Arreagaaa/ARQUI2_2S2026_G-5/status.md

# PORTUS Fase 2 - Estado del Proyecto

Fecha: 2026-09-29
Version: 1.3.0
Estado al 26-10-2026: fases 1, 2 y 3 terminadas según confirmación del equipo. La verificación automatizada registró 34 pruebas y 12 escenarios de lógica correctos; las mediciones físicas individuales no están versionadas. Las secciones históricas de este archivo describen el estado en la fecha de cada sesión.

---

## 1. Resumen de Fase 1

La Fase 1 construyo el nucleo fisico y de control determinista de la terminal portuaria sobre un microcontrolador Arduino Mega 2560. El sistema implemento identificacion RFID, pesaje dinamico con dos celdas HX711, aguja desviadora hacia ramal, zona de transferencia asistida, grua de dos grados de libertad con motores paso a paso 28BYJ-48 y electroiman, patio apilable de dos niveles monitoreado con LDRs, salida controlada y paro de emergencia en pin 18. El control opera sin retardos bloqueantes mediante maquinas de estado y ticks del Timer2. Como unico detalle de hardware registrado, el sensor IR de transferencia (pin 25) presentaba lecturas bajas constantes atribuibles a cableado fisico en la maqueta.

---

## 2. Contexto de Fase 2

PORTUS Fase 2 integra la maqueta fisica con una plataforma digital completa ejecutada en un computador de placa unica (Raspberry Pi 3). El objetivo es gobernar remotamente la terminal, gestionar la cadena documental aduanera y comercial (manifiestos, declaraciones de mercancias, levante, canal verde/rojo), administrar logicamente un parqueo de retencion de 3 plazas para resolver discrepancias de peso o documentos, programar citas de transportistas y supervisar en tiempo real sin recarga periodica de base de datos.

### 2.1 Arquitectura del Sistema

```
[ Arduino Mega 2560 ]
        |
   (USB Serial /dev/ttyACM0 o COMx, 115200 baud, protocolo delimitado con CRC)
        v
[ Bridge Python (pySerial <-> MQTT paho) ]
        |
   (Broker MQTT Mosquitto / amqtt local, puerto 1883)
        +---> portus/evt/*   (Eventos del controlador y telemetria)
        +---> portus/cmd/*   (Comandos remotos y respuestas)
        v
[ Servidor Web Flask + SSE/WebSocket + SQLite ]
        |
   (HTTP/WebSocket - Red Local)
        v
[ Interfaces Web por Rol: TERMINAL, NAVIERA, AGENTE, AUTORIDAD ]
        +
[ Servicio de Mensajeria Transportista: Comandos CLI/Telegram + Notificaciones ]
```

### 2.2 Protocolo Serial
- Formato de trama: `[SEQ:TIPO:CMD:CARGA:CRC]\n`
- Delimitadores: corchetes `[` y `]`, terminador salto de linea `\n`.
- Secuencia: entero incremental 0-65535 para deteccion de paquetes perdidos.
- Verificacion: CRC16-CCITT en hexadecimal (4 caracteres).
- Confirmacion: todo comando emitido desde el servidor recibe ACK o NAK con causa explicita de rechazo evaluada por el controlador.

### 2.3 Espacio de Topicos MQTT (Prefijo portus Obligatorio)
- `portus/evt/garita`: eventos de identificacion, validacion y rechazos.
- `portus/evt/pesaje`: lecturas de entrada y salida, muestras y comparacion con tolerancia.
- `portus/evt/aguja`: estado fisico y logico de la aguja (recta, parqueo, liberacion).
- `portus/evt/transferencia`: alineacion de camion, inicio, aborto y fin de transferencia.
- `portus/evt/grua`: pasos del ciclo (reposo, izaje, traslado, deposito, referencia, fallas).
- `portus/evt/patio`: cambios de ocupacion por nivel y posicion con ID de contenedor.
- `portus/evt/salida`: verificacion y paso por puerta de salida.
- `portus/evt/alarma`: catalogo de alarmas AL01 a AL14 con severidad y datos.
- `portus/evt/estado`: latido periodico cada 5 segundos.
- `portus/cmd/solicitud`: comandos remotos despachados desde la plataforma.
- `portus/cmd/respuesta`: aceptacion o rechazo emitido por el controlador.

### 2.4 Stack Tecnologico
- Servidor web: Python Flask con soporte de SSE / WebSockets para entrega en tiempo real de eventos MQTT al navegador (latencia menor a 2 segundos sin polling).
- Base de datos: SQLite con esquema relacional para persistencia local.
- Intermediario MQTT: Eclipse Mosquitto (nativo en Linux/Raspberry Pi) y fallback compatible amqtt (Python) para desarrollo multiplataforma.
- Enlace serial: Python pySerial con hilo dedicado de lectura/escritura no bloqueante.
- Canal de mensajeria: Servicio conversacional modular con soporte de consola/HTTP y bot de Telegram.

---

## 3. Referencia del Firmware Arduino Mega 2560

### 3.1 Sensores (Entradas)

| Pin | Nombre | Tipo | Logica | Funcion |
|-----|---|---|---|---|
| 2 | PIN_IR_ESPERA | Digital | LOW = presencia | Garita de espera |
| 3 | PIN_IR_PESAJE | Digital | LOW = presencia | Plataforma de pesaje |
| 25 | PIN_IR_TRANSFERENCIA | Digital | LOW = presencia | Zona de transferencia |
| 26 | PIN_IR_RAMAL | Digital | LOW = presencia | Entrada al ramal/parqueo |
| 19 | PIN_IR_SALIDA | Digital | LOW = presencia | Puerta de salida |
| 38 | PIN_FC_CONTACTO | Digital | LOW = contacto | Fin de carrera vertical grua |
| A0 | PIN_MARCA_OPTICA | Analogico/Digital | LOW = marca | Marca de posicion riel grua |
| 18 | PIN_PARO_EMERGENCIA | Digital (INT5) | LOW = activo | Paro de emergencia fisico |
| 22 | PIN_HX711_DOUT1 | Digital | Datos | Celda de carga extremo A |
| 23 | PIN_HX711_DOUT2 | Digital | Datos | Celda de carga extremo B |
| 24 | PIN_HX711_SCK | Salida digital | Reloj | Reloj compartido celdas |
| 50 | MISO (SPI) | Digital | Bus SPI | Lector RFID RC522 |
| 51 | MOSI (SPI) | Digital | Bus SPI | Lector RFID RC522 |
| 52 | SCK (SPI) | Digital | Bus SPI | Lector RFID RC522 |
| 53 | PIN_RFID_SS | Digital | Salida | Slave Select RFID RC522 |
| 10 | PIN_RFID_RST | Digital | Salida | Reset RFID RC522 |
| A8 | LDR Posicion 0 Nivel 0 | Analogico | Lectura LDR | Presencia contenedor P0 N0 |
| A9 | LDR Posicion 0 Nivel 1 | Analogico | Lectura LDR | Presencia contenedor P0 N1 |
| A10 | LDR Posicion 1 Nivel 0 | Analogico | Lectura LDR | Presencia contenedor P1 N0 |
| A11 | LDR Posicion 1 Nivel 1 | Analogico | Lectura LDR | Presencia contenedor P1 N1 |

### 3.2 Actuadores (Salidas)

| Pin | Nombre | Tipo | Funcion |
|-----|---|---|---|
| 5 | PIN_SERVO_TALANQUERA | Servo PWM | Apertura y cierre de garita (0=cerrado, 90=abierto) |
| 7 | PIN_SERVO_AGUJA | Servo PWM | Aguja desviadora (0=recta, 90=ramal) |
| 8 | PIN_FLECHA_VERDE | Digital | Indicador aceptado hacia transferencia |
| 9 | PIN_FLECHA_AMBAR | Digital | Indicador retenido hacia ramal |
| 30-33 | PIN_TRANS_IN1..4 | Digital | Driver ULN2003 motor traslacion horizontal |
| 34-37 | PIN_IZAJE_IN1..4 | Digital | Driver ULN2003 motor izaje vertical |
| 39 | PIN_ELECTROIMAN | Digital | Rele de activacion de electroiman |
| 40-42 | PIN_SEM_GARITA_R/A/V | Digital | Semaforo garita |
| 43-45 | PIN_SEM_TRANSF_R/A/V | Digital | Semaforo transferencia |
| A12-A13| YARD_LED_PIN[0..1] | Digital | LEDs indicadores de posicion de patio |
| 20 (SDA)| I2C SDA | I2C | Pantalla LCD 16x2 (Direccion 0x27) |
| 21 (SCL)| I2C SCL | I2C | Pantalla LCD 16x2 (Direccion 0x27) |

### 3.3 Puertos Seriales del Arduino Mega
- `Serial` (Pines 0 RX0, 1 TX0): Conectado al chip USB a serial del Arduino. Usado en Fase 1 a 115200 baud para consola y diagnostico. Se utiliza para la conexion USB directa con la Raspberry Pi sin requerir cableado adicional.
- `Serial1` (Pines 19 RX1, 18 TX1): No disponible como UART porque los pines 18 y 19 estan ocupados como GPIO para PIN_PARO_EMERGENCIA (18) y PIN_IR_SALIDA (19).
- `Serial2` (Pines 17 RX2, 16 TX2): Libre de uso.
- `Serial3` (Pines 15 RX3, 14 TX3): Libre de uso.

### 3.4 Recursos de Temporizadores y Concurrencia
- `Timer2`: Configurado en Weighing.cpp para tick base de 100 microsegundos compartido con Crane.cpp.
- `Timer1, Timer3, Timer4, Timer5`: Reservados por la libreria `Servo.h` en Arduino Mega.
- Baudrate de enlace serial: 115200 baudios.

---

## 4. Plan de Trabajo e Implementacion

1. Protocolo serial bidireccional delimitado con CRC16 y secuencia (`PortusFase2/bridge/serial_protocol.py`).
2. Simulador de controlador y maqueta para validacion de los 15 escenarios y pruebas sin hardware (`PortusFase2/bridge/mock_controller.py`).
3. Puente de comunicacion Serial-MQTT (`PortusFase2/bridge/serial_bridge.py`) con publicacion en `portus/evt/*`, atencion a `portus/cmd/*` y latido cada 5 segundos con deteccion de enlace perdido (AL01 tras 3 periodos sin latido).
4. Base de datos relacional SQLite (`PortusFase2/server/database.py`) con modelo completo de usuarios, roles, permisos, manifiestos, declaraciones, turnos, retenciones, alarmas, patio, grua, telemetria y citas.
5. Capa de autenticacion y matriz de permisos aplicada estrictamente en backend (`PortusFase2/server/auth.py`).
6. Maquina de estados del turno con los 10 estados exactos del enunciado (`PortusFase2/server/turn_manager.py`).
7. Administrador logico del parqueo de retencion (3 plazas, causas RT01 a RT06, resoluciones Aclarar, Corregir, Rechazar con efecto fisico y notificaciones).
8. Servidor Web Flask con arquitectura de distribucion en tiempo real sin polling (`PortusFase2/server/app.py`).
9. Interfaz completa del rol TERMINAL: sinoptico en vivo (SVG/Canvas dinamico), bandeja de turnos con linea de tiempo, bandeja de retenciones, inventario de patio, control e historial de grua, panel de alarmas activas/historicas con reconocimiento, citas y reportes de corrida con las 8 metricas.
10. Interfaces web para roles NAVIERA, AGENTE y AUTORIDAD con la cadena documental completa y aislamiento de datos por naviera.
11. Servicio de mensajeria del TRANSPORTISTA con los 7 comandos obligatorios y las 9 notificaciones automaticas.
12. Script maestro de inicio unificado (`PortusFase2/run_fase2.py`) e instrucciones claras de despliegue.

---

## 5. Progreso del Proyecto

| Modulo / Requisito | Estado | Observaciones / Comando de prueba |
|---|---|---|
| Revision de firmware Fase 1 y definicion de pines/puertos | Completado | Documentado en esta especificacion |
| Protocolo serial estructurado con CRC16 | Completado | `python PortusFase2/bridge/serial_protocol.py` |
| Simulador de controlador Arduino Mega | Completado | `python PortusFase2/bridge/mock_controller.py` |
| Puente Serial-MQTT bidireccional | Completado | `python PortusFase2/bridge/serial_bridge.py` |
| Base de datos SQLite y semillas de los 6 usuarios minimos | Completado | `python PortusFase2/server/database.py` |
| Autenticacion y matriz de permisos en backend | Completado | Verificado con matriz de 5 roles |
| Maquina de estados de turno (10 estados) | Completado | Gestion de transiciones y pesaje |
| Parqueo de retencion (3 plazas, RT01-RT06, 3 resoluciones) | Completado | Evaluacion de roles autorizados |
| Pestaña Operacion (Sinoptico en vivo por suscripcion) | Completado | Actualizacion en tiempo real < 2s |
| Pestaña Turnos y linea de tiempo detallada | Completado | Historial completo de eventos |
| Pestaña Retenciones | Completado | Acciones Aclarar, Corregir, Rechazar |
| Pestaña Patio e inventario | Completado | Niveles, permanencia y bloqueos |
| Pestaña Grua y metricas de ciclo | Completado | Cola, historial de fallas y exportacion |
| Pestaña Alarmas (AL01-AL14 con reconocimiento manual) | Completado | Filtros y reconocimiento individual/masivo |
| Interfaces NAVIERA, AGENTE, AUTORIDAD | Completado | Cadena de levante y selectivo rojo/verde |
| SPA React (nueva interfaz visual) | Completado | `pnpm dev` / `pnpm build` en `PortusFase2/frontend` |
| Pestaña Citas y agenda en franjas de 15 min | Completado | Validacion de franjas y ventanas |
| Pestaña Reportes con 8 metricas y exportacion CSV | Completado | Calculo de indicadores de corrida |
| Canal de mensajeria de Transportista (7 comandos, 9 avisos) | Completado | Telegram real con `TELEGRAM_BOT_TOKEN`, sin token opera con `/api/mensajeria/simulador` |
| Documento Tecnico y Especificacion de Fase 2 | Completado | `docs/Fase2/DOCUMENTO-TECNICO.md` |
| Mapa de Pines, Hardware y Conexiones | Completado | `docs/Fase2/MAPA-PINES-Y-HARDWARE.md` |
| Manual de Despliegue y Guia de 15 Escenarios | Completado | `docs/Fase2/MANUAL-DESPLIEGUE-Y-PRUEBAS.md` |
| Script maestro de arranque unificado | Completado | `python PortusFase2/run_fase2.py` |

---

## 6. Decisiones de Diseno y Justificacion

1. **Uso del puerto Serial USB principal (115200 baud):**
   El Arduino Mega tiene conectados los pines 18 y 19 al paro de emergencia y al sensor IR de salida, lo cual inhabilita el uso de `Serial1`. El puerto `Serial` USB es el unico que no requiere cableado fisico adicional hacia la Raspberry Pi 3.

2. **Protocolo serial encapsulado con CRC16-CCITT:**
   Para evitar corrupcion de tramas en presencia de ruido electromagnetico de motores ULN2003 y celdas de carga, se eligio delimitacion por caracteres `[` y `]` junto a un CRC16 computado sobre la carga util, con un numero de secuencia continuo para detectar paquetes perdidos en el puente.

3. **Adaptacion bidireccional en el Bridge Serial-MQTT:**
   Para cumplir la Regla 1 (no alterar el firmware ya calificado de Fase 1), el puente en Python reconoce tanto las tramas formadas por el protocolo estructurado de Fase 2 como las salidas impresas por la consola de Fase 1, traduciendolas a los topicos obligatorios `portus/evt/*`. Esto permite conectar la maqueta original sin reprogramar el microcontrolador si no se desea, o bien activar la extension estructurada.

4. **Entrega al navegador mediante Server-Sent Events (SSE) / WebSocket conectado a MQTT:**
   El enunciado prohibe expresamente el polling a la base de datos para actualizar el sinoptico y exige latencia menor a 2 segundos. El servidor Flask se suscribe al broker MQTT y retransmite inmediatamente cada evento recibido hacia los clientes web conectados, garantizando consumo reactivo y bandera de desconexion visible con marca de tiempo.

5. **Parqueo logico de 3 plazas reutilizando la aguja desviadora:**
   El ramal fisico de Fase 1 se reutiliza como parqueo de retencion. La logica de asignacion asigna la plaza libre de menor indice (1, 2 o 3) y comanda la aguja hacia `AgujaParqueo`. Al resolver mediante Aclarar o Corregir, se comanda `AgujaLiberar` y el vehiculo regresa al carril principal.

6. **Aislamiento estricto de datos:**
   Las navieras unicamente pueden ver y operar sus propios manifiestos y contenedores. Los transportistas solo pueden consultar la carga que tienen asignada. Cualquier intento de consulta no autorizada es bloqueado en la capa de aplicacion y base de datos, retornando error explicito.

---

## 7. Sesion 2026-09-23 - Migracion de interfaces a SPA React

### 7.1 Decision: vanilla JS / Jinja2 -> React + TypeScript + Vite + Tailwind

Se empezo la sesion contemplando el uso de JavaScript vanilla sobre las vistas Jinja2 existentes. Se revirtio esa decision de forma consciente una vez que el alcance funcional del backend estaba cubierto (mas del 70%): con la logica de negocio ya lista, el tiempo restante conviene invertirlo en calidad visual y mantenibilidad de la UI, no en DOM manual. La SPA nueva no reemplaza la logica del servidor; consume exactamente los mismos endpoints REST y el mismo stream SSE.

- **Framework:** React 18 + TypeScript 5 + Vite 5 + Tailwind CSS 3
- **Gestor de paquetes:** pnpm (no npm). En `pnpm-workspace.yaml` se aprobo el build de `esbuild` (`allowBuilds`).
- **Routing:** react-router-dom 6, rutas anidadas bajo `AppShell` (cabecera permanente + pestañas por rol).
- **Tiempo real:** `EventSource` nativo sobre `/api/stream/events` (hook `useSinopticoStream`). El sinoptico se actualiza **solo por suscripcion SSE**; queda prohibido el polling a la base de datos.
- **HTTP:** `fetch` nativo con wrapper propio (`src/api/client.ts`); sin axios.
- **Iconografia:** lucide-react. Cero emojis en la UI.
- **Graficas:** recharts (metricas de ciclo de grua y reportes).

### 7.2 Diseno visual elegido y por que

Estetica de panel NOC / centro de control industrial: densa, legible en sala de operaciones, estados inequivocos.

| Elemento | Eleccion | Motivo |
|---|---|---|
| Acento | Cian `#0EA5E9` | Asociacion a senal informativa/de enlace; contraste alto sobre fondos oscuros |
| Fondos | `#0A0E14` / `#111823` / `#18212F` | Tres niveles de superficie (pagina, panel, elevado) sin glassmorphism |
| Estados | Verde `#22C55E`, ambar `#F59E0B`, rojo `#EF4444`, gris `#6B7280` | Semantica invariante en todo el producto; misma codificacion que el semaforo de la maqueta |
| Tipografia | Inter (UI) + JetBrains Mono (IDs tecnicos) | Inter para lectura rapida; monoespaciada para manifiestos, contenedores y codigos de alarma |
| Modo | Oscuro por defecto | Reduce fatiga visual en operacion continua; no se implemento toggle claro (fuera de alcance de la sesion) |

Reglas aplicadas: sin gradientes decorativos, sin glassmorphism, sin tarjetas flotantes innecesarias; tablas y paneles densos con jerarquia tipografica clara.

### 7.3 Estado de cada pantalla

| Pantalla (ruta) | Rol | Estado | Notas |
|---|-----|---|---|
| Login `/login` | todos | Completa | POST `/api/login`, redirige por rol via `/api/me` |
| Operacion `/terminal/operacion` | TERMINAL | Completa | Sinoptico SVG + comandos remotos; datos solo de SSE |
| Turnos `/terminal/turnos` | TERMINAL | Completa | Tabla + linea de tiempo por turno |
| Retenciones `/terminal/retenciones` | TERMINAL | Completa | Plazas reales desde retenciones ABIERTAS (ver gap 7.6) |
| Patio `/terminal/patio` | TERMINAL | Completa | Inventario 2 niveles x posiciones, bloqueos |
| Grua `/terminal/grua` | TERMINAL | Completa | Cola, historial, metricas recharts |
| Alarmas `/terminal/alarmas` | TERMINAL | Completa | Filtros severidad/estado, ACK individual y masivo |
| Citas `/terminal/citas` | TERMINAL | Completa | Agenda con cancelar, reprogramar, bloquear y desbloquear franjas |
| Reportes `/terminal/reportes` | TERMINAL | Completa | 8 metricas + export CSV |
| Manifiestos | NAVIERA | Completa | Aislamiento por naviera en servidor |
| Mis contenedores | NAVIERA | Completa | Filtro por naviera en sesion |
| Declaraciones | AGENTE | Completa | Alta de declaracion |
| Seguimiento | AGENTE | Completa | Estado documental |
| Levante | AUTORIDAD | Completa | Canal verde/rojo, solicitar levante |
| Retenciones aduaneras | AUTORIDAD | Completa | Acciones de autoridad |
| Consulta de carga | AUTORIDAD | Completa | Vision transversal |

Pestaña **Transportista**: no aplica web (solo canal de mensajeria), segun el enunciado.

### 7.4 Comandos de ejecucion

```bash
# Desarrollo (proxy /api -> Flask :5000)
cd PortusFase2/frontend
pnpm install
pnpm dev          # http://localhost:5173

# Build de produccion (tsc + vite build -> frontend/dist)
pnpm build

# Backend completo (Flask en :5000, sirve dist si existe)
cd ..   # PortusFase2
run_fase2.bat
# o: python PortusFase2/run_fase2.py --mock
```

En desarrollo se usa la SPA en 5173 con proxy. En produccion, Flask sirve `frontend/dist` (catch-all de rutas de navegacion y assets). No se uso `flask-cors`: el proxy de Vite y el same-origin de Flask eliminan la necesidad. `requirements.txt` sin cambios.

### 7.5 Archivos backend tocados (aditivos, en `PortusFase2/server/app.py`)

| Cambio | Lineas aprox. | Por que |
|---|---|---|
| Import `send_from_directory` | ~20 | Servir `frontend/dist` |
| Constante `FRONTEND_DIST` | ~17-18 | Ruta al build de la SPA |
| `_servir_spa_si_existe()` | junto a rutas de navegacion | Las vistas Jinja2 `/`, `/login`, `/terminal`, etc. sirven el index de React si el build existe; si no, conservan el comportamiento original |
| `GET /api/me` | ~90 | La SPA restaura usuario+rol tras recargar (sin el, habria que reloguear) |
| `GET /api/transportistas` | ~420 | Combo de transportistas en formularios (turnos/citas) |
| `GET /api/catalogo/contenedores` | ~430 | Catalogo de tipos/tara de contenedores |
| `GET /api/declaraciones` | ~450 | Listado (opcional `?manifiesto_id=`) para el AGENTE; el POST original no se toco |
| `POST/GET /api/logout` Accept JSON | ~85 | La SPA necesita `{"success":true}` en vez de redirect a Jinja |
| Catch-all `/<path:ruta_spa>` | final de rutas | Rutas del cliente (`/terminal/operacion`, assets de Vite) y 404 JSON bajo `/api/*` |

**No se tocaron:** `auth.py`, `turn_manager.py`, `retention_manager.py`, `alarm_manager.py`, `yard_crane_manager.py`, `metrics.py`, `database.py`, firmware Fase 1, `mensajeria/`. La matriz de permisos y los decoradores siguen siendo la unica autorizacion de rol.

### 7.6 Gaps cerrados en la sesion final

1. **Citas mutables:** implementados `POST /api/citas/<id>/cancelar`, `POST /api/citas/<id>/reprogramar`, `POST /api/citas/bloquear-franja`, `POST /api/citas/desbloquear-franja` y `GET /api/citas/franjas-bloqueadas`. La UI de Citas ya permite cancelar, reprogramar, bloquear y desbloquear franjas con validacion del servidor.
2. **Creacion de turnos:** implementado `POST /api/turnos` con validacion de vehiculo, manifiesto, levante otorgado, pertenencia del transportista, ventana de cita, RT04 por llegada fuera de ventana y rechazo AL11 por parqueo lleno.
3. **Campo `parqueo` del SSE:** `terminal_state['parqueo']` se sincroniza con el retention manager al iniciar el stream, al recibir latidos y al crear o resolver retenciones.
4. **Contrato frontend/backend:** corregido el consumo de `GET /api/transportistas` y `GET /api/catalogo/contenedores` en la SPA para usar los arreglos reales devueltos por Flask.

### 7.7 Limpieza de interfaz Jinja2 (misma sesion)

Se eliminaron los artefactos de la UI anterior ya reemplazada por React:

| Eliminado | Motivo |
|---|---|
| `PortusFase2/server/templates/` (base, login, terminal, naviera, agente, autoridad) | Solo las usaba Flask con `render_template`; la SPA las sustituye |
| `PortusFase2/server/static/` (`js/app.js`, `js/realtime.js`, `css/style.css`) | Assets de esas templates |
| `__pycache__/` y `*.pyc` en disco (ademas del untrack en git) | Artefactos de Python |

En `app.py` se quitaron `render_template`, `template_folder` y `static_folder` (`static_folder=None`). Las rutas de navegacion (`/`, `/login`, `/terminal`, …) sirven `frontend/dist`; si no hay build responden `503` con la instruccion `pnpm build`. La autorizacion por rol en la API no cambio.

### 7.8 Verificacion de la sesion

- `pnpm build`: **OK** (`tsc` sin errores + Vite bundle `dist/`).
- Import de `PortusFase2.server.app`: **OK**; rutas nuevas presentes en `url_map`.
- Smoke con `app.test_client()`: `/api/me`, logout JSON, transportistas, catalogo, declaraciones, serve de `/`, `/login`, `/terminal/operacion` y assets desde `dist` responden 200 con el contenido esperado; `/api/*` inexistente responde 404 JSON.
- `py -3.13 -m unittest discover -s tests -v`: **OK**, 17 pruebas API/integracion.
- `py -3.13 tests\\validate_scenarios.py -v`: **OK**, cobertura logica de E01 a E15.
- `pnpm exec playwright test tests/playwright_smoke.spec.js --browser=chromium --reporter=line`: **OK**, login y navegacion real en Chromium para TERMINAL y carga de catalogos NAVIERA.

### 7.9 Estado registrado en esa sesión

En esa sesión el software quedó cerrado a nivel de servidor, API, SPA, mensajería simulada, permisos, agenda, retenciones, reportes y pruebas automatizadas. La integración física se registró como trabajo por realizar en ese momento. El estado actual se resume al inicio de este archivo y en la [bitácora de fase 3](docs/Fase3/BITACORA-Y-EVIDENCIAS.md).

---

## 8. Sesion 2026-09-29 - Canal de mensajeria del transportista completo

### 8.1 Que se habilito

El canal de mensajeria dejo de ser solo logica de negocio sin salida: hoy los avisos llegan al transportista por Telegram y la agenda se opera desde el telefono.

| Entregable | Archivo |
|---|---|
| Cola de entrega asincrona con hilo emisor y hilo de recordatorios | `PortusFase2/mensajeria/notifier.py` |
| Bot de Telegram con long polling (`getUpdates`), hilo daemon e idempotente | `PortusFase2/mensajeria/telegram_bot.py` |
| `/cita` en 3 pasos con oferta de franjas, texto libre dentro del flujo y TTL de 300 s | `PortusFase2/mensajeria/messaging_service.py` |
| 8 puntos de notificacion en la API (antes solo `logging.info`) | `PortusFase2/server/app.py` |
| Aviso de turno cerrado y anulado en la telemetria | `PortusFase2/server/telemetry.py::_observe` |
| RT01/RT02 con alarma `AL09`, comando `AgujaParqueo` y evidencia de peso | `PortusFase2/server/app.py::_evaluar_pesaje_tol` |
| Panel *Vinculacion de transportista* en la pestana Citas | `frontend/src/pages/terminal/CitasPage.tsx` |
| Estado `Vinculado`/`Sin vincular` por transportista | `GET /api/transportistas` |
| Migracion aditiva `citas.recordatorio_enviado` | `server/database.py` |
| Arranque de los 3 hilos solo desde el script maestro | `run_fase2.py` |

### 8.2 Las 9 notificaciones automaticas: de log a transportista

Levante otorgado, levante retenido, cita asignada, recordatorio de cita (1 hora antes, una sola vez), vehiculo retenido (RT01-RT06), retencion resuelta, cita cancelada/reprogramada, turno cerrado y turno anulado. Antes todas terminaban en `logging.info`; hoy se encolan con `notifier.send()` y se entregan al `chat_id` vinculado.

### 8.3 Diseno degradado (decision aprobada)

- Sin `TELEGRAM_BOT_TOKEN`: los avisos se registran con `[SIN TELEGRAM]` y el sistema opera igual que antes.
- Sin cuenta vinculada: `[SIN CANAL]` y el transportista siempre recibe la solicitud de `/vincular`.
- Sin Internet: la API de Telegram falla, el hilo reintenta y ninguna peticion HTTP de Flask ni el hilo MQTT esperan jamas.
- Los hilos se arrancan solo desde `run_fase2.py`, para que los tests que importan `server/app.py` sigan siendo hermeticos.

### 8.4 Proteccion del RT01 en la maqueta

La bascula fisica pesa en escala de modelo (aprox. 1160 g) mientras que un manifiesto puede declarar tonelaje de terminal (22000 g). Si se compararan directamente, **todos** los pesajes caerian en RT01 y se romperia el proceso feliz. Por eso `_evaluar_pesaje_tol` no genera retencion cuando el orden de magnitud entre medido y declarado supera 10 veces: deja la advertencia `fuera de escala comparable` en el log y la retencion queda bajo criterio manual (`RT06`). Para demostrar E07 declare en el manifiesto el peso real de la maqueta.

### 8.5 Verificacion

- `py -3.13 -m unittest discover -s tests`: vuelve exactamente al baseline previo (5 fallas preexistentes en `test_api_gaps`, ajenas a esta sesion; verificado contra arbol limpio con `git stash`).
- `py -3.13 tests\validate_scenarios.py`: **OK**, 12 pruebas (dos de ellas ajustadas al nuevo flujo de `/cita` en 3 pasos).
- `npm run build` en `frontend`: **OK** (`tsc` + Vite).
- Smoke funcional propio de 24 verificaciones: **OK** (vinculacion, cita en 3 pasos, texto libre, entrega de avisos, recordatorios, cierre/anulacion de turno, RT01, no duplicado, proteccion de escala, RT02).

### 8.6 Como probarlo

1. `cd PortusFase2 && py -3.13 run_fase2.py --mock`.
2. Sin token: entrar como `operador1` en *Citas*, generar codigo, y enviar los comandos a `POST /api/mensajeria/simulador`.
3. Con token: pegar `TELEGRAM_BOT_TOKEN` en `PortusFase2/.env`, reiniciar y operar el bot desde el telefono.
