Arreagaaa/ARQUI2_2S2026_G-5/Docs 3D/Grua_Simulacion.png

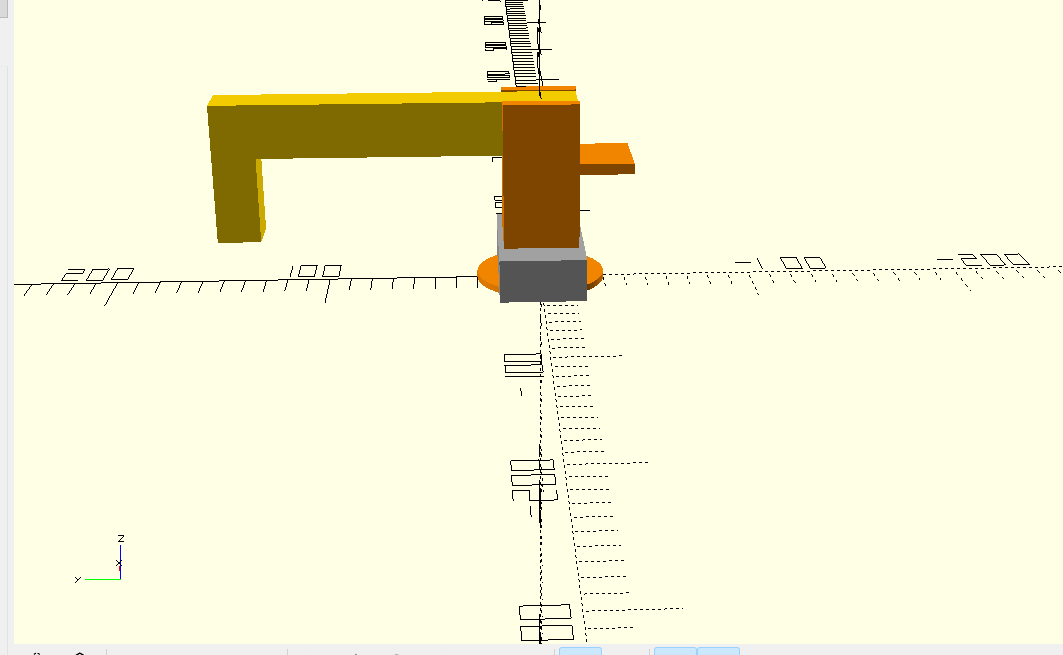
Docs 3D/Grua_Simulacion.png
