Arreagaaa/ARQUI2_2S2026_G-5/docs/Fase1/media/image/diagrama-pines.png

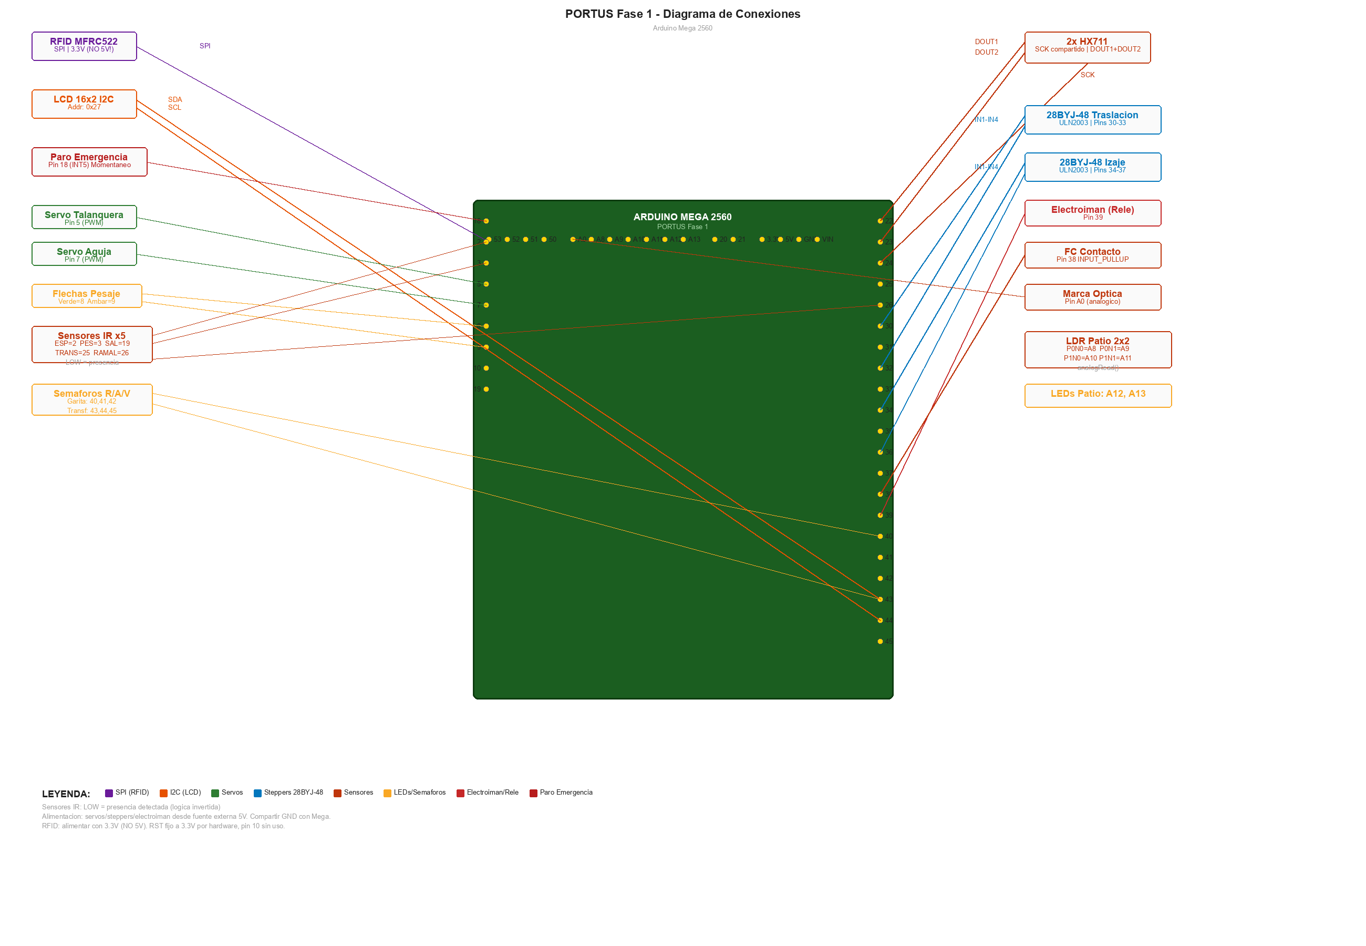
docs/Fase1/media/image/diagrama-pines.png
