Arreagaaa/ARQUI2_2S2026_G-5/docs/media/image/pesaje.jpeg

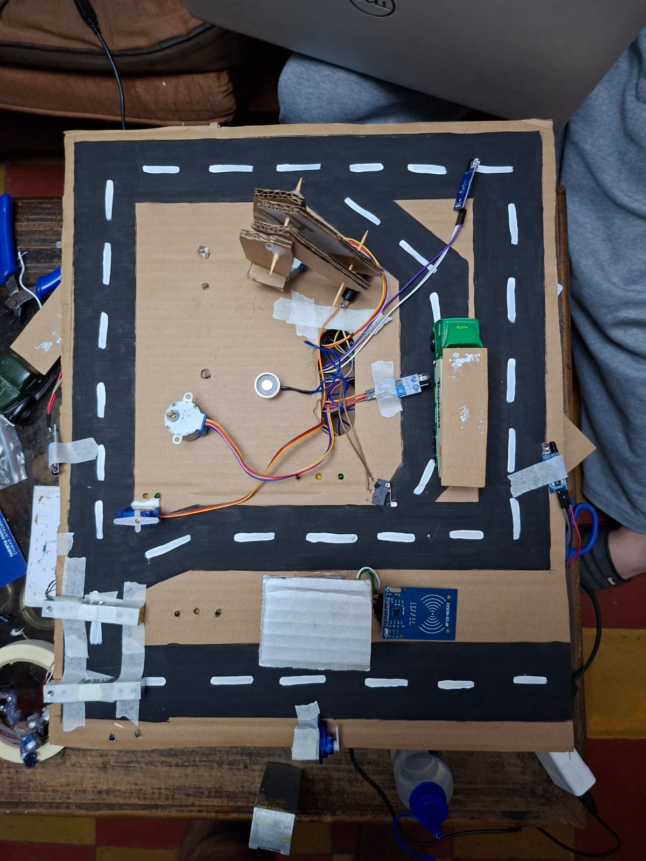
docs/media/image/pesaje.jpeg
