Arreagaaa/ARQUI2_2S2026_G-5/Docs 3D/Gruaaa definitive.stl

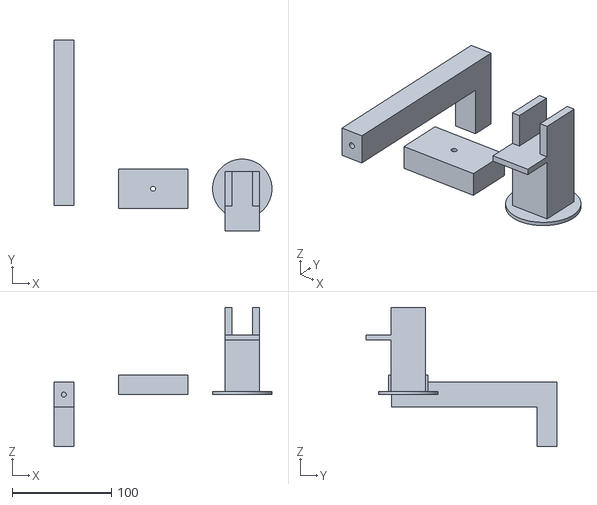
[picture p8: CAD file, 2026-10-23]
Docs 3D/Gruaaa definitive.stl
220.0 x 192.5 x 140.5
