Arreagaaa/ARQUI2_2S2026_G-5/Docs 3D/Conteiners_talanquera.stl

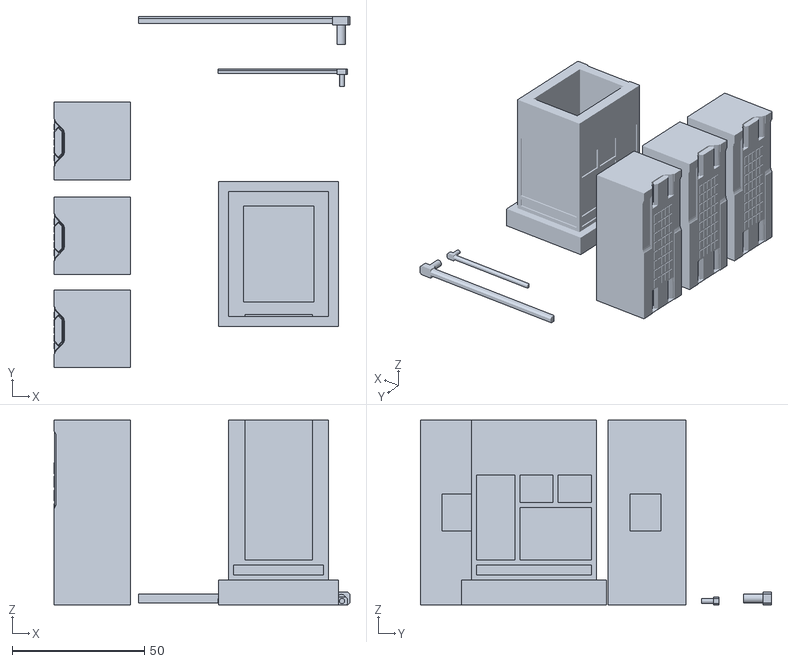
[picture p9: CAD file, 2026-10-23]
Docs 3D/Conteiners_talanquera.stl
112.0 x 133.0 x 70.0
