Arreagaaa/ARQUI2_2S2026_G-5/docs/Fase3/INVENTARIO-FABRICACION-3D.md

# PORTUS — Inventario 3D de la maqueta

**Estado al 26-10-2026:** el equipo confirmó que la fabricación y el montaje de la maqueta se completaron. Este inventario registra los modelos publicados en Git. El recuento físico completo, las fuentes editables y el cálculo del porcentaje de componentes fabricados en 3D no están versionados, de modo que el repositorio por sí solo no permite auditar el umbral del 40 % del enunciado.

## Modelos disponibles

| Archivo | Descripción identificable por el nombre | Formato |
| --- | --- | --- |
| [Brazo grua.stl](../../Docs%203D/Brazo%20grua.stl) | Brazo de grúa | STL |
| [Pivote Grua.stl](../../Docs%203D/Pivote%20Grua.stl) | Pivote de grúa | STL |
| [Gruaaa definitive.stl](../../Docs%203D/Gruaaa%20definitive.stl) | Conjunto de grúa | STL |
| [Conteiners_talanquera.stl](../../Docs%203D/Conteiners_talanquera.stl) | Contenedores y talanquera | STL |
| [cascard.stl](../../Docs%203D/cascard.stl) | Pieza identificada como `cascard` en el archivo fuente | STL |
| [Grua_Simulacion.png](../../Docs%203D/Grua_Simulacion.png) | Vista de simulación de la grúa | PNG |

Estos archivos documentan piezas modeladas, pero un STL no demuestra cuántas copias se imprimieron ni qué proporción representan en la maqueta terminada. La confirmación de fabricación corresponde al equipo responsable. Para repetir una auditoría del porcentaje se necesitan el recuento de componentes físicos y las fotografías de cada pieza instalada.
