Arreagaaa/ARQUI2_2S2026_G-5/PortusFase2/server/app.py

"""
Servidor web principal para PORTUS Fase 2.
Construido sobre Flask, con autenticacion por roles, matriz de permisos en backend,
distribucion de eventos en tiempo real via Server-Sent Events (SSE) sin polling,
y endpoints REST para la cadena documental y los comandos remotos.
"""

import os
import secrets
import copy
import json
import re
import uuid
import time
import queue
import logging
import threading
from datetime import datetime, timezone, timedelta

# Ruta absoluta al build de la SPA React (frontend/dist) para el modo produccion.
FRONTEND_DIST = os.path.join(os.path.dirname(os.path.dirname(os.path.abspath(__file__))), "frontend", "dist")

from flask import Flask, request, jsonify, session, redirect, url_for, Response, send_from_directory
import paho.mqtt.client as mqtt

from .database import get_db_connection, init_database
from .auth import authenticate_user, login_required, require_permission, PERMISOS_MATRIZ
from .turn_manager import (
    create_turn, transition_turn, get_turn_timeline, add_timeline_event,
    get_active_turn_by_vehicle
)
from .retention_manager import (
    get_parking_occupancy, assign_retention, resolve_retention, CAUSAS_ROLES
)
from .alarm_manager import raise_alarm, acknowledge_alarm, acknowledge_all_low_medium, get_alarms
from .yard_crane_manager import (
    get_yard_inventory, update_yard_on_physical_confirmation, set_position_blocked,
    get_crane_history, record_crane_cycle
)
from .metrics import calculate_metrics, export_report_csv
from . import fase3
from ..mensajeria.messaging_service import TransportistaMessagingService, generate_binding_code
from ..mensajeria import notifier

logging.basicConfig(level=logging.INFO, format="%(asctime)s [%(levelname)s] %(message)s")

app = Flask(__name__, static_folder=None)
app.secret_key = os.environ.get("PORTUS_SESSION_SECRET") or secrets.token_hex(32)

# Colas de transmision en tiempo real para clientes SSE conectados
event_queues = []
event_queues_lock = threading.Lock()

# Ultimo estado conocido de la maqueta y del enlace
# Servicio de mensajeria
init_database()
from .telemetry import initial_state, process_event
terminal_state = initial_state()
telemetry_lock = threading.RLock()
msg_service = TransportistaMessagingService()

# Cliente MQTT del servidor
mqtt_client: mqtt.Client = None
fase3_instance_id = uuid.uuid4().hex


def _fase3_publish(topic, data):
    if mqtt_client:
        mqtt_client.publish(topic, json.dumps(data), qos=1)


def _fase3_broadcast(topic, data):
    terminal_state["fase3"] = data
    dispatch_event_to_sse({"topic": topic, "data": data, "state": copy.deepcopy(terminal_state)})


fase3_runtime = fase3.Runtime(_fase3_publish, _fase3_broadcast)
terminal_state["fase3"] = fase3_runtime.snapshot()


def _refresh_parqueo_state():
    """
    Sincroniza terminal_state['parqueo'] con el retention manager (fuente real
    de las plazas ocupadas). Cada plaza ocupada expone vehiculo, turno, causa
    y tiempo de retencion transcurrido, tal como exige el sinoptico.
    """
    try:
        ocupacion = get_parking_occupancy()
        now = datetime.now(timezone.utc)
        parqueo = {}
        for plaza, ret in ocupacion.items():
            if ret is None:
                parqueo[plaza] = None
                continue
            retencion_min = 0
            try:
                t_ini = datetime.fromisoformat(ret["tiempo_inicio"])
                retencion_min = int((now - t_ini).total_seconds() / 60)
            except Exception:
                pass
            parqueo[plaza] = {
                "vehiculo": ret["placa_vehiculo"],
                "codigo_turno": ret["codigo_turno"],
                "codigo_retencion": ret["codigo_retencion"],
                "causa": ret["causa"],
                "tiempo_retencion_min": retencion_min
            }
        terminal_state["parqueo"] = parqueo
    except Exception as e:
        logging.error("No se pudo refrescar el estado del parqueo: %s", e)


def dispatch_event_to_sse(event_data: dict):
    with event_queues_lock:
        dead_queues = []
        for q in event_queues:
            try:
                q.put_nowait(copy.deepcopy(event_data))
            except queue.Full:
                # Slow client: discard oldest snapshot, keep current state.
                try:
                    q.get_nowait()
                    q.put_nowait(copy.deepcopy(event_data))
                except queue.Empty:
                    pass
            except Exception:
                dead_queues.append(q)
        for dq in dead_queues:
            if dq in event_queues:
                event_queues.remove(dq)


def on_mqtt_message(client, userdata, msg):
    try:
        if msg.topic == "portus/cmd/solicitud":
            payload = json.loads(msg.payload.decode("utf-8"))
            if payload.get("comando") == "CapturaFin":
                # La camara libero su bloqueo: restablecer el modo vigente.
                with telemetry_lock:
                    fase3_runtime.lights = None
                    fase3_runtime.light_rule()
            return
        if msg.topic in ("portus/estacion/lectura", "portus/estacion/estado"):
            payload = json.loads(msg.payload.decode("utf-8"))
            with telemetry_lock:
                fase3_runtime.ingest(msg.topic, payload)
            return
        if msg.topic == "portus/vision/estado":
            payload = json.loads(msg.payload.decode("utf-8"))
            with telemetry_lock:
                fase3_runtime.last_camera_heartbeat = time.monotonic()
                fase3_runtime.set_camera(payload.get("operativa") is True, publish=False)
                if not payload.get("operativa") and fase3_runtime.pending_access_id:
                    conn = get_db_connection()
                    try:
                        conn.execute("UPDATE fase3_accesos SET resultado='MODO DEGRADADO' WHERE id=?",
                                     (fase3_runtime.pending_access_id,))
                        conn.commit()
                    finally:
                        conn.close()
            return
        if msg.topic == "portus/vision/cola":
            payload = json.loads(msg.payload.decode("utf-8"))
            if isinstance(payload.get("cantidad"), int) and payload["cantidad"] >= 0:
                with telemetry_lock:
                    fase3_runtime.set_queue(payload["cantidad"], publish=False)
            return
        if msg.topic == "portus/vision/placa":
            payload = json.loads(msg.payload.decode("utf-8"))
            _fase3_record_plate(payload)
            return
        if not (msg.topic.startswith("portus/evt/") or msg.topic == "portus/cmd/respuesta"):
            return
        data = json.loads(msg.payload.decode("utf-8"))
        if msg.topic == "portus/evt/garita" and data.get("tipo") == "GaritaModo":
            with telemetry_lock:
                fase3_runtime.gate_enabled = str(data.get("datos", {}).get("activo")) == "1"
                fase3_runtime.emit()
        if msg.topic == "portus/evt/garita" and data.get("tipo") == "GaritaRFID" and fase3_runtime.gate_enabled:
            _fase3_begin_access(str(data.get("datos", {}).get("uid") or ""))
        if data.get("tipo") == "Fase3Retencion":
            _fase3_physical_retention(data.get("datos") or {})
        with telemetry_lock:
            if process_event(terminal_state, data, msg.topic):
                _fase3_link_accesses()
                _refresh_parqueo_state()
                dispatch_event_to_sse({"topic": msg.topic, "data": data, "state": copy.deepcopy(terminal_state)})
                _evaluar_pesaje_tol(data)
    except Exception:
        logging.exception("Error procesando telemetria MQTT")


def _fase3_record_plate(data):
    uid = str(data.get("uid") or "").upper()
    if not uid:
        return
    attempts = data.get("intentos") if isinstance(data.get("intentos"), list) else [data]
    if not attempts:
        return
    chosen = attempts[-1]
    for candidate in attempts:
        try:
            test = fase3.verify_plate(uid, candidate.get("placa"), float(candidate.get("confianza")))
        except (TypeError, ValueError):
            continue
        if test["resultado"] != "VERIFICACION MANUAL":
            chosen = candidate
            break
    confidence = chosen.get("confianza")
    try:
        confidence = float(confidence) if confidence is not None else None
    except (ValueError, TypeError):
        confidence = None
    result = fase3.verify_plate(uid, chosen.get("placa"), confidence)
    conn = get_db_connection()
    try:
        pending = fase3_runtime.pending_access_id if fase3_runtime.gate_enabled else None
        if pending:
            active = conn.execute("SELECT rfid_uid FROM fase3_accesos WHERE id=?", (pending,)).fetchone()
            if not active or str(active["rfid_uid"]).upper() != uid:
                pending = None
        manual_required = bool(pending and fase3_runtime.pending_since is None)
        effective_result = "VERIFICACION MANUAL" if manual_required else result["resultado"]
        if pending:
            conn.execute("""UPDATE fase3_accesos SET placa_leida=?,confianza=?,placa_esperada=?,resultado=?,foto=? WHERE id=? AND rfid_uid=?""",
                         (fase3.norm_plate(chosen.get("placa")), confidence, result.get("placa_esperada"),
                          effective_result, chosen.get("foto"), pending, uid))
            access_id = pending
            fase3_runtime.pending_access_id = None
            fase3_runtime.pending_since = None
        else:
            cur = conn.execute("""INSERT INTO fase3_accesos
                (timestamp,rfid_uid,placa_leida,confianza,placa_esperada,resultado,foto)
                VALUES (?,?,?,?,?,?,?)""",
                (fase3.now(), uid, fase3.norm_plate(chosen.get("placa")), confidence,
                 result.get("placa_esperada"), result["resultado"], chosen.get("foto")))
            access_id = cur.lastrowid
        for index, attempt in enumerate(attempts, start=1):
            if attempt.get("foto"):
                conn.execute("INSERT INTO fase3_fotos(acceso_id,intento,ruta,placa_leida,confianza) VALUES (?,?,?,?,?)",
                             (access_id, index, attempt["foto"], fase3.norm_plate(attempt.get("placa")),
                              attempt.get("confianza")))
        conn.commit()
    finally:
        conn.close()
    alarms = {"PLACA NO COINCIDE": "AL20", "PLACA RESTRINGIDA": "AL21",
              "VERIFICACION MANUAL": "AL22"}
    if result["resultado"] in alarms:
        from .telemetry import alarm_once
        alarm_once(alarms[result["resultado"]], {"acceso_id": access_id})
    if pending and not manual_required and result["resultado"] in ("PLACA VERIFICADA", "PLACA NO COINCIDE", "PLACA RESTRINGIDA"):
        decision = {"PLACA VERIFICADA": "AUTORIZAR", "PLACA NO COINCIDE": "RETENER07",
                    "PLACA RESTRINGIDA": "RETENER08"}[result["resultado"]]
        fase3_runtime.command("GaritaResultado", resultado=decision, placa=result["placa_leida"])
    if result["resultado"] == "PLACA VERIFICADA" and chosen.get("foto") and result.get("transportista_id"):
        conn = get_db_connection()
        try:
            row = conn.execute("""SELECT contenedor_id,tipo_operacion FROM turnos
                WHERE placa_vehiculo=? ORDER BY id DESC LIMIT 1""", (result["placa_esperada"],)).fetchone()
        finally:
            conn.close()
        container = row["contenedor_id"] if row else "sin turno vinculado"
        operation = row["tipo_operacion"] if row else "sin operacion vinculada"
        notifier.send_photo(result["transportista_id"], chosen["foto"],
            f"Ingreso verificado: {result['placa_leida']} a las {fase3.now()}. Contenedor: {container}. Operacion: {operation}.")
    with telemetry_lock:
        _fase3_link_accesses()
        terminal_state["fase3"]["ultimo_acceso"] = {"id": access_id, **result}
        dispatch_event_to_sse({"topic": "portus/vision/placa", "data": {"id": access_id, **result},
                               "state": copy.deepcopy(terminal_state)})


def _fase3_begin_access(uid):
    if not uid:
        return
    result = "LEYENDO PLACA" if fase3_runtime.camera_online else "MODO DEGRADADO"
    conn = get_db_connection()
    try:
        cur = conn.execute("INSERT INTO fase3_accesos(timestamp,rfid_uid,resultado) VALUES (?,?,?)",
                           (fase3.now(), uid.upper(), result))
        conn.commit()
        fase3_runtime.pending_access_id = cur.lastrowid
        fase3_runtime.pending_since = time.monotonic()
    finally:
        conn.close()
    if result == "MODO DEGRADADO":
        from .telemetry import alarm_once
        alarm_once("AL18")
    with telemetry_lock:
        terminal_state["fase3"]["ultimo_acceso"] = {"id": fase3_runtime.pending_access_id, "resultado": result}
        dispatch_event_to_sse({"topic": "portus/vision/placa", "state": copy.deepcopy(terminal_state)})


def _fase3_physical_retention(values):
    plate = fase3.norm_plate(values.get("placa"))
    cause = values.get("causa")
    if not plate or cause not in ("RT07", "RT08"):
        return
    turn = get_active_turn_by_vehicle(plate)
    if not turn:
        logging.warning("Retencion fisica %s sin turno digital para %s", cause, plate)
        return
    conn = get_db_connection()
    try:
        exists = conn.execute("SELECT 1 FROM retenciones WHERE turno_id=? AND causa=?", (turn["id"], cause)).fetchone()
    finally:
        conn.close()
    if exists:
        return
    retained = assign_retention(turn["id"], cause, "PESAJE",
                                observacion=f"Desvio fisico por {cause} tras pesaje")
    if not retained:
        from .telemetry import alarm_once
        alarm_once("AL11", {"descripcion": "Parqueo lleno ante retencion de placa"})
        return
    fase3.audit("automatico", "retencion_placa", {"placa": plate, "causa": cause, "plaza": retained["plaza"]})
    notifier.send(turn["transportista_id"],
                  f"PORTUS: vehiculo {plate} retenido por {cause} en plaza {retained['plaza']}.")


def _fase3_link_accesses():
    """Asocia una captura al turno cuando la telemetria crea el turno real."""
    conn = get_db_connection()
    try:
        pending = conn.execute("""SELECT a.*,c.placa AS catalog_plate FROM fase3_accesos a
            JOIN catalogo_camiones c ON UPPER(c.rfid_uid)=UPPER(a.rfid_uid)
            WHERE a.turno_id IS NULL AND a.resultado IN
            ('PLACA VERIFICADA','PLACA NO COINCIDE','PLACA RESTRINGIDA','CONFIRMAR')""").fetchall()
        linked = []
        for access in pending:
            turn = conn.execute("SELECT id,tiempo_inicio FROM turnos WHERE placa_vehiculo=? ORDER BY id DESC LIMIT 1",
                                (access["catalog_plate"],)).fetchone()
            if not turn:
                continue
            try:
                age = abs((datetime.fromisoformat(turn["tiempo_inicio"]) - datetime.fromisoformat(access["timestamp"])).total_seconds())
            except (TypeError, ValueError):
                continue
            if age > 300:
                continue
            conn.execute("UPDATE fase3_accesos SET turno_id=? WHERE id=?", (turn["id"], access["id"]))
            linked.append((turn["id"], access))
        conn.commit()
    finally:
        conn.close()
    for turn_id, access in linked:
        add_timeline_event(turn_id, "servidor", "Verificacion de placa en garita",
                           {"acceso_id": access["id"], "placa": access["placa_leida"],
                            "resultado": access["resultado"], "foto": access["foto"]})


# Umbral de orden de magnitud entre el pesaje fisico y el declarado.
# La maqueta pesa en gramos (p. ej. 1160 g) mientras que un manifiesto puede
# declarar tonelaje de terminal (p. ej. 22500 g). Si las dos escalas no son
# comparables no se genera retencion automatica: se deja constancia en el log y
# la retencion queda bajo criterio manual (RT06). Asi un pesaje dentro del
# proceso feliz nunca cae en RT01 por incompatibilidad de unidades.
ESCALA_MAX_RATIO = 10.0


def _peso_del_evento(data, es_declarado=False):
    """
    Extrae el peso (kg) de un evento PesajeLectura, del campo numerico o del
    texto de detalle. Acepta el evento completo y su carga util anidada en
    'datos', porque segun el puente llega de las dos formas.
    """
    clave = "declarado_kg" if es_declarado else "peso"
    alternativa = None if es_declarado else "declarado"
    patron = r"declarado:\s*([-\d.]+)" if es_declarado else r"Peso leido:\s*([-\d.]+)"
    internos = data.get("datos")
    fuentes = [data, internos] if isinstance(internos, dict) else [data]
    for fuente in fuentes:
        for nombre in ((clave,) if alternativa is None else (clave, alternativa)):
            valor = fuente.get(nombre)
            if valor is None:
                continue
            try:
                return float(valor)
            except (TypeError, ValueError):
                break
        m = re.search(patron, str(fuente.get("detalle", "")))
        if m:
            try:
                return float(m.group(1))
            except ValueError:
                return None
    return None


def _turno_para_pesaje():
    """Turno que corresponde al pesaje: por placa identificada, por estacion o el unico activo."""
    placa = terminal_state.get("pesaje_placa")
    if placa:
        turno = get_active_turn_by_vehicle(placa)
        if turno:
            return dict(turno)
    conn = get_db_connection()
    try:
        for estacion in ("PESAJE", "SALIDA"):
            fila = conn.execute(
                "SELECT * FROM turnos WHERE estacion_actual=? AND estado_actual NOT IN ('Cerrado','Anulado') "
                "ORDER BY id DESC LIMIT 1", (estacion,)
            ).fetchone()
            if fila:
                return dict(fila)
        activos = conn.execute(
            "SELECT * FROM turnos WHERE estado_actual NOT IN ('Cerrado','Anulado') ORDER BY id DESC LIMIT 2"
        ).fetchall()
        if len(activos) == 1:
            return dict(activos[0])
        return None
    finally:
        conn.close()


def _evaluar_pesaje_tol(data):
    """
    RT01/RT02: genera la retencion cuando el pesaje excede la tolerancia del
    manifiesto y lanza la alarma AL09. Nunca propaga excepciones: forma parte del
    camino de telemetria.
    """
    if not isinstance(data, dict) or data.get("tipo") != "PesajeLectura":
        return
    peso_kg = _peso_del_evento(data)
    if peso_kg is None or peso_kg <= 0:
        return
    turno = _turno_para_pesaje()
    if not turno:
        return
    declarado_kg = None
    tolerancia = 5.0
    conn = get_db_connection()
    try:
        manifiesto = None
        if turno.get("manifiesto_id"):
            manifiesto = conn.execute(
                "SELECT peso_declarado_g, tolerancia_pct FROM manifiestos WHERE id=?",
                (turno["manifiesto_id"],)
            ).fetchone()
        if manifiesto:
            declarado_kg = (manifiesto["peso_declarado_g"] or 0) / 1000.0
            tolerancia = float(manifiesto["tolerancia_pct"] or 5.0)
        if not declarado_kg:
            declarado_kg = (turno.get("peso_declarado_g") or 0) / 1000.0
        if not declarado_kg:
            declarado_kg = _peso_del_evento(data, es_declarado=True)
        if not declarado_kg or declarado_kg <= 0:
            return
        if max(peso_kg, declarado_kg) / min(peso_kg, declarado_kg) > ESCALA_MAX_RATIO:
            logging.warning(
                "Pesaje %s kg vs declarado %s kg fuera de escala comparable: no se genera RT01",
                peso_kg, declarado_kg
            )
            return
        diferencia = abs(peso_kg - declarado_kg)
        if diferencia <= declarado_kg * tolerancia / 100.0:
            return
        es_salida = turno.get("estacion_actual") == "SALIDA"
        causa = "RT02" if es_salida else "RT01"
        abierta = conn.execute(
            "SELECT 1 FROM retenciones WHERE turno_id=? AND estado='ABIERTA'", (turno["id"],)
        ).fetchone()
        if abierta:
            return
        estacion = "SALIDA" if es_salida else "PESAJE"
        peso_declarado_g = int(round(declarado_kg * 1000))
        peso_medido_g = int(round(peso_kg * 1000))
    finally:
        conn.close()

    raise_alarm("AL09", origen="servidor", datos={
        "turno": turno.get("codigo"), "causa": causa,
        "peso_declarado_g": peso_declarado_g, "peso_medido_g": peso_medido_g,
        "diferencia_g": abs(peso_medido_g - peso_declarado_g),
        "diferencia_pct": round(abs(peso_medido_g - peso_declarado_g) * 100.0 / peso_declarado_g, 2),
    })
    resumen = assign_retention(
        turno["id"], causa, estacion=estacion,
        peso_declarado_g=peso_declarado_g, peso_medido_g=peso_medido_g,
    )
    if not resumen:
        raise_alarm("AL11", origen="servidor", datos={"turno": turno.get("codigo"), "causa": causa})
        return
    if mqtt_client:
        try:
            mqtt_client.publish("portus/cmd/aguja", json.dumps({
                "evento": "RetencionCreada", "turno": turno.get("codigo"), "causa": causa, "estacion": estacion,
            }))
        except Exception:
            logging.exception("No se pudo publicar el desvio de la aguja")
    notifier.send(
        turno["transportista_id"],
        msg_service.notify_vehiculo_retenido(
            turno["transportista_id"], turno.get("placa_vehiculo"), turno.get("contenedor_id"), causa,
            peso_dec=peso_declarado_g, peso_med=peso_medido_g,
        )
    )
    _refresh_parqueo_state()
    dispatch_event_to_sse({"topic": "portus/evt/retencion", "data": resumen,
                           "state": copy.deepcopy(terminal_state)})
    logging.info(
        "Retencion %s generada por discrepancia de peso: declarado %s g, medido %s g",
        causa, peso_declarado_g, peso_medido_g
    )


def init_mqtt():
    global mqtt_client
    mqtt_client = mqtt.Client(client_id=f"portus_server_{uuid.uuid4().hex[:6]}")
    def on_connect(client, userdata, flags, rc):
        if rc == 0:
            client.subscribe("portus/#")
            # Un reinicio pierde el acceso pendiente en memoria. Cerrar el
            # modo remoto evita que el Mega espere una decision inexistente.
            fase3_runtime.command("GaritaModo", activo=False)
    mqtt_client.on_connect = on_connect
    mqtt_client.on_message = on_mqtt_message
    def supervise():
        from .telemetry import alarm_once
        while True:
            time.sleep(2)
            with telemetry_lock:
                fase3_runtime.tick()
                if (fase3_runtime.camera_online and fase3_runtime.last_camera_heartbeat and
                    time.monotonic() - fase3_runtime.last_camera_heartbeat > 15):
                    fase3_runtime.set_camera(False)
                if (fase3_runtime.pending_access_id and fase3_runtime.pending_since and
                    time.monotonic() - fase3_runtime.pending_since > fase3.params()["SegundosEsperaVerificacion"]):
                    conn = get_db_connection()
                    try:
                        conn.execute("UPDATE fase3_accesos SET resultado='VERIFICACION MANUAL' WHERE id=? AND resultado='LEYENDO PLACA'",
                                     (fase3_runtime.pending_access_id,))
                        conn.commit()
                    finally:
                        conn.close()
                    from .telemetry import alarm_once
                    alarm_once("AL22")
                    fase3_runtime.pending_since = None
                _fase3_publish("portus/fase3/latido", {"timestamp": fase3.now(), "instancia": fase3_instance_id})
                stamp = terminal_state.get('ultimo_latido_timestamp')
                if stamp and terminal_state['enlace']=='CONECTADO':
                    elapsed = (datetime.now(timezone.utc)-datetime.fromisoformat(stamp)).total_seconds()
                    if elapsed > 15:
                        terminal_state['enlace']='DESCONECTADO'
                        terminal_state['sincronizado']=False
                        alarm_once('AL01')
                        dispatch_event_to_sse({'topic':'portus/evt/estado','state':copy.deepcopy(terminal_state)})
    threading.Thread(target=supervise, daemon=True).start()
    try:
        mqtt_client.connect("localhost", 1883, keepalive=60)
        mqtt_client.loop_start()
        logging.info("Servidor web conectado a MQTT en localhost:1883 (suscrito a portus/#)")
    except Exception as e:
        logging.warning("No se pudo conectar a MQTT en localhost:1883: %s", e)


@app.after_request
def notify_mutation(response):
    if request.method in ('POST', 'PUT', 'PATCH', 'DELETE') and response.status_code < 400 and request.path.startswith('/api/'):
        dispatch_event_to_sse({'topic': 'portus/refresh', 'state': copy.deepcopy(terminal_state)})
    return response


@app.before_request
def protect_operational_data():
    user = session.get('user')
    if not user:
        return
    path = request.path
    if user['rol'] != 'TERMINAL' and any(path.startswith(prefix) for prefix in ('/api/grua', '/api/alarmas', '/api/citas', '/api/reportes')):
        return jsonify({'error': 'Acceso exclusivo de TERMINAL'}), 403
    if user['rol'] not in ('TERMINAL','AUTORIDAD') and path.startswith('/api/retenciones'):
        return jsonify({'error': 'Rol sin acceso a retenciones'}), 403
    physical_action = path.startswith('/api/patio/posicion/') or path == '/api/cmd/remote' or (path == '/api/turnos' and request.method=='POST') or (path.startswith('/api/turnos/') and (path.endswith('/retener-manual') or path.endswith('/anular'))) or (path.startswith('/api/retenciones/') and path.endswith('/resolver'))
    if physical_action and request.method=='POST' and terminal_state.get('protocolo')=='fase1' and user['rol']!='TERMINAL':
        return jsonify({'error':'Acceso exclusivo de TERMINAL'}), 403
    if physical_action and request.method=='POST' and terminal_state.get('protocolo')=='fase1':
        return jsonify({'error': 'Fase1 opera localmente. Esta conexion supervisa el hardware; no admite esta orden remota.'}), 409


# -------------------------------------------------------------
# RUTAS DE AUTENTICACION Y NAVEGACION
# -------------------------------------------------------------
def _servir_spa_si_existe():
    """Sirve el index de la SPA React si frontend/dist ya fue construido."""
    indice = os.path.join(FRONTEND_DIST, "index.html")
    if os.path.isfile(indice):
        return send_from_directory(FRONTEND_DIST, "index.html")
    return None


def _spa_no_construida():
    """Respuesta cuando no hay build de React (olvido de `pnpm build`)."""
    return (
        "Frontend React no construido. Ejecute: cd PortusFase2/frontend && pnpm install && pnpm build",
        503,
        {"Content-Type": "text/plain; charset=utf-8"},
    )


@app.route("/")
def index():
    spa = _servir_spa_si_existe()
    if spa is not None:
        return spa
    return _spa_no_construida()


@app.route("/login")
def login_page():
    spa = _servir_spa_si_existe()
    if spa is not None:
        return spa
    return _spa_no_construida()


@app.route("/api/login", methods=["POST"])
def api_login():
    data = request.get_json() or {}
    username = data.get("username", "").strip()
    password = data.get("password", "").strip()

    user = authenticate_user(username, password)
    if not user:
        return jsonify({"error": "Credenciales invalidas. Verifique usuario y contraseña."}), 401

    if user["rol"] == "TRANSPORTISTA":
        return jsonify({"error": "El rol TRANSPORTISTA no tiene acceso a la aplicacion web. Debe operar desde el canal de mensajeria."}), 403

    session["user"] = user
    return jsonify({
        "success": True,
        "user": user,
        "redirect": url_for("index")
    })


@app.route("/api/logout", methods=["POST", "GET"])
def api_logout():
    session.clear()
    # La SPA React pide sesion JSON; las vistas Jinja2 antiguas conservan el redirect.
    if request.headers.get("Accept", "").find("application/json") >= 0 or request.is_json:
        return jsonify({"success": True})
    return redirect(url_for("login_page"))


@app.route("/api/me")
def api_me():
    """
    Devuelve el usuario en sesion para que la SPA React restaure su contexto
    tras recargar la pagina. Sin sesion valida responde user: null.
    """
    user = session.get("user")
    return jsonify({"user": user})


# -------------------------------------------------------------
# RUTAS DE NAVEGACION POR ROL (sirven la SPA; el control de rol
# de cada pestaña sigue vivo en la matriz de permisos de la API)
# -------------------------------------------------------------
@app.route("/terminal")
@login_required
def view_terminal():
    spa = _servir_spa_si_existe()
    if spa is not None:
        return spa
    return _spa_no_construida()


@app.route("/naviera")
@login_required
def view_naviera():
    spa = _servir_spa_si_existe()
    if spa is not None:
        return spa
    return _spa_no_construida()


@app.route("/agente")
@login_required
def view_agente():
    spa = _servir_spa_si_existe()
    if spa is not None:
        return spa
    return _spa_no_construida()


@app.route("/autoridad")
@login_required
def view_autoridad():
    spa = _servir_spa_si_existe()
    if spa is not None:
        return spa
    return _spa_no_construida()


# -------------------------------------------------------------
# EVENT STREAMING (SSE) - SIN POLLING (REQUISITO ESTRICTO)
# -------------------------------------------------------------
@app.route("/api/stream/events")
@login_required
def sse_events():
    user = dict(session['user'])
    def visible_event(event):
        if user['rol'] == 'TERMINAL':
            return event
        # Other roles receive invalidation only; REST applies ownership filters.
        return {'topic': 'portus/refresh', 'data': {'timestamp': datetime.now(timezone.utc).isoformat()},
                'state': {k: terminal_state[k] for k in ('enlace', 'ultimo_latido_timestamp', 'fuente', 'protocolo')}}
    def event_generator():
        q = queue.Queue(maxsize=100)
        with event_queues_lock:
            event_queues.append(q)
        try:
            with telemetry_lock:
                _refresh_parqueo_state()
                initial = visible_event({"topic":"portus/init", "state":copy.deepcopy(terminal_state)})
            yield f"data: {json.dumps(initial)}\n\n"
            while True:
                try:
                    event = q.get(timeout=10.0)
                    yield f"data: {json.dumps(visible_event(event))}\n\n"
                except queue.Empty:
                    yield ": keepalive\n\n"
        finally:
            with event_queues_lock:
                if q in event_queues:
                    event_queues.remove(q)

    return Response(event_generator(), mimetype="text/event-stream", headers={"Cache-Control": "no-cache", "X-Accel-Buffering": "no"})


# -------------------------------------------------------------
# API: COMANDOS REMOTOS (ROL TERMINAL)
# -------------------------------------------------------------
@app.route("/api/cmd/remote", methods=["POST"])
@login_required
@require_permission("emitir_comandos_remotos")
def execute_remote_command():
    data = request.get_json() or {}
    comando = data.get("comando")
    parametros = data.get("parametros", {})

    if not comando:
        return jsonify({"error": "Comando no especificado"}), 400
    if comando in ("GaritaResultado", "GaritaModo", "CapturaInicio", "CapturaFin",
                   "IluminacionEncender", "IluminacionApagar"):
        return jsonify({"error": "Este comando se gestiona desde la regla de Fase 3"}), 403
    if comando == "GruaReanudar" and fase3_runtime.suspended_since:
        return jsonify({"error": "La grua suspendida por lluvia solo se reanuda automaticamente"}), 409
    if comando in ("GruaSuspender", "GruaReanudar") and parametros.get("motivo") == "Clima":
        return jsonify({"error": "El motivo Clima se reserva para la regla automatica"}), 403

    # Publicar comando a portus/cmd/solicitud
    msg_id = str(uuid.uuid4())
    msg_out = {
        "id": msg_id,
        "timestamp": datetime.now(timezone.utc).isoformat(),
        "origen": "servidor",
        "tipo": "SolicitudComando",
        "comando": comando,
        "parametros": parametros,
        "usuario": session["user"]["username"]
    }

    if mqtt_client:
        mqtt_client.publish("portus/cmd/solicitud", json.dumps(msg_out), qos=1)

    return jsonify({"success": True, "message": f"Comando '{comando}' despachado al controlador"})


# -------------------------------------------------------------
# API: MANIFIESTOS (NAVIERA / TERMINAL / AGENTE / AUTORIDAD)
# -------------------------------------------------------------
@app.route("/api/manifiestos", methods=["GET"])
@login_required
@require_permission("ver_manifiesto_completo")
def list_manifiestos():
    user = session["user"]
    conn = get_db_connection()

    if user["rol"] == "NAVIERA":
        # Aislamiento estricto: solo sus propios manifiestos
        rows = conn.execute("""
        SELECT * FROM manifiestos WHERE naviera_id = ? ORDER BY id DESC
        """, (user["username"],)).fetchall()
    else:
        rows = conn.execute("SELECT * FROM manifiestos ORDER BY id DESC").fetchall()

    conn.close()
    return jsonify([dict(r) for r in rows])


@app.route("/api/manifiestos", methods=["POST"])
@login_required
@require_permission("crear_manifiesto")
def create_manifiesto():
    data = request.get_json() or {}
    user = session["user"]

    contenedor_id = data.get("contenedor_id", "").strip().upper()
    from .telemetry import CATALOG
    configured = next((entry for entry in CATALOG.values() if entry['contenedor']==contenedor_id), None)
    if configured and configured['naviera'] != user['username']:
        return jsonify({'error':'El contenedor fisico esta asociado a otra naviera'}), 403

    tipo_operacion = data.get("tipo_operacion")
    peso_declarado = data.get("peso_declarado")
    tolerancia = data.get("tolerancia", 5.0)
    transportista_id = data.get("transportista_id")
    observaciones = data.get("observaciones", "")

    # Validaciones obligatorias
    if not contenedor_id or not tipo_operacion or peso_declarado is None or not transportista_id:
        return jsonify({"error": "Faltan campos obligatorios"}), 400

    try:
        peso_declarado = int(peso_declarado)
        if peso_declarado <= 0:
            return jsonify({"error": "El peso declarado debe ser mayor que cero"}), 400
    except ValueError:
        return jsonify({"error": "Peso declarado invalido"}), 400

    try:
        tolerancia = float(tolerancia)
    except ValueError:
        tolerancia = 5.0

    conn = get_db_connection()
    # 1. Validar que exista en catalogo
    cat = conn.execute("SELECT id FROM catalogo_contenedores WHERE id = ?", (contenedor_id,)).fetchone()
    if not cat:
        conn.close()
        return jsonify({"error": f"El contenedor '{contenedor_id}' no existe en el catalogo oficial de la maqueta"}), 400

    # 2. Regla: Un contenedor no podra tener dos manifiestos pendientes al mismo tiempo
    pendiente = conn.execute("""
    SELECT id FROM manifiestos
    WHERE contenedor_id = ? AND estado_documental NOT IN ('CERRADO', 'ANULADO')
    """, (contenedor_id,)).fetchone()
    if pendiente:
        conn.close()
        return jsonify({"error": f"El contenedor '{contenedor_id}' ya posee un manifiesto activo ({pendiente['id']})"}), 400

    c = conn.cursor()
    c.execute("SELECT COUNT(*) as count FROM manifiestos")
    count = c.fetchone()["count"] + 1
    manif_id = f"MAN-{count:04d}"

    now = datetime.now(timezone.utc).isoformat()
    c.execute("""
    INSERT INTO manifiestos (
        id, contenedor_id, naviera_id, tipo_operacion, peso_declarado_g,
        tolerancia_pct, transportista_id, observaciones, estado_documental,
        created_at, updated_at
    ) VALUES (?, ?, ?, ?, ?, ?, ?, ?, 'CREADO', ?, ?)
    """, (manif_id, contenedor_id, user["username"], tipo_operacion, peso_declarado, tolerancia, transportista_id, observaciones, now, now))
    conn.commit()
    conn.close()

    return jsonify({"success": True, "id": manif_id, "message": "Manifiesto declarado exitosamente"})


@app.route("/api/manifiestos/<manif_id>/anular", methods=["POST"])
@login_required
@require_permission("crear_manifiesto")
def anular_manifiesto(manif_id):
    user = session["user"]
    conn = get_db_connection()
    manif = conn.execute("SELECT * FROM manifiestos WHERE id = ?", (manif_id,)).fetchone()

    if not manif:
        conn.close()
        return jsonify({"error": "Manifiesto no encontrado"}), 404

    if manif["naviera_id"] != user["username"]:
        conn.close()
        return jsonify({"error": "No puede anular manifiestos de otra naviera"}), 403

    # Verificar que no tenga turno asociado
    turno = conn.execute("SELECT id FROM turnos WHERE manifiesto_id = ?", (manif_id,)).fetchone()
    if turno:
        conn.close()
        return jsonify({"error": "No se puede anular un manifiesto que ya posee un turno asociado"}), 400

    conn.execute("UPDATE manifiestos SET estado_documental = 'ANULADO' WHERE id = ?", (manif_id,))
    conn.commit()
    conn.close()
    return jsonify({"success": True, "message": "Manifiesto anulado exitosamente"})


# -------------------------------------------------------------
# API: CATALOGOS PARA FORMULARIOS DE LA SPA
# -------------------------------------------------------------
@app.route("/api/transportistas")
@login_required
def list_transportistas():
    conn = get_db_connection()
    rows = conn.execute("""
        SELECT u.username, u.nombre_completo,
               (SELECT COUNT(*) FROM vinculaciones_transportista v
                WHERE v.transportista_id = u.username AND v.usado = 1
                  AND v.chat_id IS NOT NULL AND v.chat_id <> '') AS chats_vinculados
        FROM usuarios u
        WHERE u.rol = 'TRANSPORTISTA'
        ORDER BY u.username
    """).fetchall()
    conn.close()
    return jsonify([dict(r) for r in rows])


@app.route("/api/catalogo/contenedores")
@login_required
def list_catalogo_contenedores():
    conn = get_db_connection()
    rows = conn.execute("SELECT id, tipo, tara_g FROM catalogo_contenedores ORDER BY id").fetchall()
    conn.close()
    return jsonify([dict(r) for r in rows])


# -------------------------------------------------------------
# API: DECLARACIONES Y LEVANTE ADUANERO (AGENTE / AUTORIDAD)
# -------------------------------------------------------------
@app.route("/api/declaraciones", methods=["GET"])
@login_required
@require_permission("ver_manifiesto_completo")
def list_declaraciones():
    manifiesto_id = request.args.get("manifiesto_id")
    conn = get_db_connection()
    if manifiesto_id:
        rows = conn.execute(
            "SELECT * FROM declaraciones WHERE manifiesto_id = ? ORDER BY id DESC",
            (manifiesto_id,),
        ).fetchall()
    else:
        rows = conn.execute("SELECT * FROM declaraciones ORDER BY id DESC").fetchall()
    if session['user']['rol']=='NAVIERA':
        own = {r[0] for r in conn.execute('SELECT id FROM manifiestos WHERE naviera_id=?', (session['user']['username'],))}
        rows = [r for r in rows if r['manifiesto_id'] in own]
    conn.close()
    return jsonify([dict(r) for r in rows])


@app.route("/api/declaraciones", methods=["POST"])
@login_required
@require_permission("presentar_declaracion")
def create_declaracion():
    data = request.get_json() or {}
    user = session["user"]

    manifiesto_id = data.get("manifiesto_id")
    numero_declaracion = data.get("numero_declaracion", "").strip()
    regimen = data.get("regimen")
    descripcion_mercancia = data.get("descripcion_mercancia", "").strip()
    valor_declarado = data.get("valor_declarado")
    observaciones = data.get("observaciones", "")

    if not manifiesto_id or not numero_declaracion or not regimen or not descripcion_mercancia or valor_declarado is None:
        return jsonify({"error": "Faltan campos obligatorios"}), 400

    if len(descripcion_mercancia) < 10:
        return jsonify({"error": "La descripcion de mercancia debe contener minimo 10 caracteres"}), 400

    try:
        valor_declarado = float(valor_declarado)
        if valor_declarado <= 0:
            return jsonify({"error": "El valor declarado debe ser mayor que cero"}), 400
    except ValueError:
        return jsonify({"error": "Valor declarado invalido"}), 400

    conn = get_db_connection()
    c = conn.cursor()

    try:
        now = datetime.now(timezone.utc).isoformat()
        c.execute("""
        INSERT INTO declaraciones (
            numero_declaracion, manifiesto_id, agente_id, regimen,
            descripcion_mercancia, valor_declarado, observaciones, created_at
        ) VALUES (?, ?, ?, ?, ?, ?, ?, ?)
        """, (numero_declaracion, manifiesto_id, user["username"], regimen, descripcion_mercancia, valor_declarado, observaciones, now))

        c.execute("""
        UPDATE manifiestos SET estado_documental = 'DECLARADO', updated_at = ? WHERE id = ?
        """, (now, manifiesto_id))

        conn.commit()
    except Exception as e:
        conn.close()
        return jsonify({"error": f"Error al registrar declaracion: {e}"}), 400

    conn.close()
    return jsonify({"success": True, "message": "Declaracion de mercancias presentada exitosamente"})


@app.route('/api/declaraciones/observacion', methods=['POST'])
@login_required
@require_permission('presentar_declaracion')
def agregar_observacion():
    data = request.get_json() or {}
    text = str(data.get('observacion','')).strip()
    if not text:
        return jsonify({'error':'Escriba una observacion'}), 400
    conn = get_db_connection()
    row = conn.execute('SELECT id FROM declaraciones WHERE manifiesto_id=? ORDER BY id DESC LIMIT 1', (data.get('manifiesto_id'),)).fetchone()
    if not row:
        conn.close()
        return jsonify({'error':'Primero presente la declaracion'}), 400
    conn.execute("UPDATE declaraciones SET observaciones=COALESCE(observaciones,'') || ? WHERE id=?", ('\n'+text,row['id']))
    conn.commit()
    conn.close()
    return jsonify({'success':True,'message':'Observacion guardada'})


@app.route("/api/declaraciones/solicitar-levante", methods=["POST"])
@login_required
@require_permission("presentar_declaracion")
def solicitar_levante():
    data = request.get_json() or {}
    manifiesto_id = data.get("manifiesto_id")

    conn = get_db_connection()
    manif = conn.execute("SELECT * FROM manifiestos WHERE id = ?", (manifiesto_id,)).fetchone()
    if not manif:
        conn.close()
        return jsonify({"error": "Manifiesto no encontrado"}), 404

    if manif["estado_documental"] not in ("DECLARADO", "LEVANTE_RETENIDO"):
        conn.close()
        return jsonify({"error": "Solo se puede solicitar levante para manifiestos con declaracion presentada"}), 400

    now = datetime.now(timezone.utc).isoformat()
    conn.execute("""
    UPDATE manifiestos SET estado_documental = 'LEVANTE_SOLICITADO', updated_at = ? WHERE id = ?
    """, (now, manifiesto_id))
    conn.commit()
    conn.close()

    return jsonify({"success": True, "message": "Solicitud de levante enviada a la Autoridad Aduanera"})


@app.route("/api/autoridad/resolver-levante", methods=["POST"])
@login_required
@require_permission("otorgar_retener_levante")
def resolver_levante():
    data = request.get_json() or {}
    manifiesto_id = data.get("manifiesto_id")
    decision = data.get("decision")  # 'OTORGAR' o 'RETENER'
    canal = data.get("canal")  # 'VERDE' o 'ROJO' (obligatorio si OTORGAR)
    motivo = data.get("motivo", "")

    if not manifiesto_id or decision not in ("OTORGAR", "RETENER"):
        return jsonify({"error": "Decision invalida"}), 400

    if decision == "OTORGAR" and canal not in ("VERDE", "ROJO"):
        return jsonify({"error": "Debe seleccionar canal VERDE o ROJO al otorgar levante"}), 400

    if decision == "RETENER" and not motivo:
        return jsonify({"error": "Debe registrar el motivo de la retencion del levante"}), 400

    conn = get_db_connection()
    manif = conn.execute("SELECT * FROM manifiestos WHERE id = ?", (manifiesto_id,)).fetchone()
    if not manif:
        conn.close()
        return jsonify({"error": "Manifiesto no encontrado"}), 404

    now = datetime.now(timezone.utc).isoformat()
    if decision == "OTORGAR":
        conn.execute("""
        UPDATE manifiestos
        SET estado_documental = 'LEVANTE_OTORGADO', canal_selectivo = ?, updated_at = ?
        WHERE id = ?
        """, (canal, now, manifiesto_id))
        conn.commit()
        conn.close()

        # Notificacion automatica obligatoria al transportista
        notifier.send(
            manif["transportista_id"],
            msg_service.notify_levante_otorgado(manif["transportista_id"], manif["contenedor_id"], canal)
        )
        return jsonify({"success": True, "message": f"Levante otorgado con canal {canal}"})
    else:
        conn.execute("""
        UPDATE manifiestos
        SET estado_documental = 'LEVANTE_RETENIDO', observaciones = ?, updated_at = ?
        WHERE id = ?
        """, (f"Retenido por SAT: {motivo}", now, manifiesto_id))
        conn.commit()
        conn.close()

        # Notificacion automatica obligatoria
        notifier.send(
            manif["transportista_id"],
            msg_service.notify_levante_retenido(manif["transportista_id"], manif["contenedor_id"], motivo)
        )
        return jsonify({"success": True, "message": "Levante retenido por Autoridad Aduanera"})


# -------------------------------------------------------------
# API: TURNOS Y OPERACION
# -------------------------------------------------------------
@app.route("/api/turnos", methods=["GET"])
@login_required
def list_turnos():
    conn = get_db_connection()
    estado = request.args.get("estado")
    tipo = request.args.get("tipo")
    busqueda = request.args.get("q")

    query = "SELECT * FROM turnos WHERE 1=1"
    params = []
    if session['user']['rol'] == 'NAVIERA':
        query += " AND (naviera_id=? OR manifiesto_id IN (SELECT id FROM manifiestos WHERE naviera_id=?))"
        params.extend([session['user']['username']]*2)

    if estado:
        query += " AND estado_actual = ?"
        params.append(estado)
    if tipo:
        query += " AND tipo_operacion = ?"
        params.append(tipo)
    if busqueda:
        query += " AND (placa_vehiculo LIKE ? OR contenedor_id LIKE ? OR codigo_turno LIKE ?)"
        b_wild = f"%{busqueda}%"
        params.extend([b_wild, b_wild, b_wild])

    query += " ORDER BY id DESC LIMIT 100"
    rows = conn.execute(query, params).fetchall()
    conn.close()

    turnos_list = []
    now = datetime.now(timezone.utc)
    for r in rows:
        item = dict(r)
        transcurrido_min = 0
        try:
            t_ini = datetime.fromisoformat(item["tiempo_inicio"])
            t_fin = datetime.fromisoformat(item["tiempo_fin"]) if item["tiempo_fin"] else now
            transcurrido_min = int((t_fin - t_ini).total_seconds() / 60)
        except Exception:
            pass
        item["tiempo_transcurrido_min"] = transcurrido_min
        turnos_list.append(item)

    return jsonify(turnos_list)


@app.route("/api/turnos/<int:turno_id>/timeline", methods=["GET"])
@login_required
def get_timeline(turno_id):
    if session['user']['rol'] == 'NAVIERA':
        conn = get_db_connection()
        row = conn.execute("SELECT 1 FROM turnos t LEFT JOIN manifiestos m ON m.id=t.manifiesto_id WHERE t.id=? AND (t.naviera_id=? OR m.naviera_id=?)", (turno_id, session['user']['username'], session['user']['username'])).fetchone()
        conn.close()
        if not row:
            return jsonify({'error':'Turno no disponible'}), 404
    timeline = get_turn_timeline(turno_id)
    return jsonify(timeline)


@app.route("/api/turnos/<int:turno_id>/retener-manual", methods=["POST"])
@login_required
@require_permission("resolver_retencion_operativa")
def retener_turno_manual(turno_id):
    data = request.get_json(silent=True) or {}
    observacion = data.get("observacion", "Retencion manual por operador")

    res = assign_retention(turno_id, "RT06", estacion="GARITA", observacion=observacion)
    if not res:
        raise_alarm("AL11", origen="servidor", datos={"descripcion": "Parqueo de retencion lleno"})
        return jsonify({"error": "Parqueo de retencion lleno (3 plazas ocupadas). No se puede enviar el vehiculo a retencion."}), 400

    # Emitir comando AgujaParqueo
    if mqtt_client:
        mqtt_client.publish("portus/cmd/solicitud", json.dumps({
            "comando": "AgujaParqueo", "parametros": {"plaza": res["plaza"]}
        }))

    # Notificacion automatica obligatoria al transportista dueño del turno
    conn = get_db_connection()
    turno = conn.execute("SELECT * FROM turnos WHERE id = ?", (turno_id,)).fetchone()
    conn.close()
    if turno:
        notifier.send(
            turno["transportista_id"],
            msg_service.notify_vehiculo_retenido(
                turno["transportista_id"], turno["placa_vehiculo"], turno["contenedor_id"], "RT06"
            )
        )

    _refresh_parqueo_state()
    dispatch_event_to_sse({"topic": "portus/evt/retencion", "data": {"tipo": "RetencionCreada", "datos": res}})
    return jsonify({"success": True, "retencion": res, "message": f"Turno retenido en plaza {res['plaza']}"})


@app.route("/api/turnos/<int:turno_id>/anular", methods=["POST"])
@login_required
@require_permission("emitir_comandos_remotos")
def anular_turno(turno_id):
    ok = transition_turn(turno_id, "Anulado", estacion="SALIDA", origen="usuario", detalle="Turno anulado manualmente por operador")
    if not ok:
        return jsonify({"error": "No se puede anular el turno en su estado actual"}), 400

    conn = get_db_connection()
    turno = conn.execute("SELECT * FROM turnos WHERE id = ?", (turno_id,)).fetchone()
    conn.close()
    if turno:
        notifier.send(
            turno["transportista_id"],
            msg_service.notify_turno_anulado(
                turno["transportista_id"], turno["placa_vehiculo"], turno["contenedor_id"],
                "Anulacion manual por operador de terminal"
            )
        )
    dispatch_event_to_sse({"topic": "portus/evt/turnos", "data": {"tipo": "TurnoAnulado", "datos": {"turno_id": turno_id}}})

    return jsonify({"success": True, "message": "Turno anulado"})


# -------------------------------------------------------------
# API: RETENCIONES Y PARQUEO (3 PLAZAS)
# -------------------------------------------------------------
@app.route("/api/retenciones", methods=["GET"])
@login_required
def list_retenciones():
    estado = request.args.get("estado")
    causa = request.args.get("causa")
    user_rol = session["user"]["rol"]

    conn = get_db_connection()
    query = """
    SELECT r.*, t.codigo_turno, t.placa_vehiculo, t.transportista_id
    FROM retenciones r
    JOIN turnos t ON r.turno_id = t.id
    WHERE 1=1
    """
    params = []

    if user_rol == "AUTORIDAD":
        # Autoridad solo ve retenciones de causa aduanera (RT03 y RT05)
        query += " AND r.causa IN ('RT03', 'RT05', 'RT08')"
    elif user_rol == "TERMINAL":
        pass  # Terminal ve todas en su pestaña de retenciones

    if estado:
        query += " AND r.estado = ?"
        params.append(estado)
    if causa:
        query += " AND r.causa = ?"
        params.append(causa)

    query += " ORDER BY r.id DESC"
    rows = conn.execute(query, params).fetchall()
    conn.close()

    now = datetime.now(timezone.utc)
    results = []
    for r in rows:
        item = dict(r)
        duracion_min = 0
        try:
            t_ini = datetime.fromisoformat(item["tiempo_inicio"])
            t_fin = datetime.fromisoformat(item["tiempo_resolucion"]) if item["tiempo_resolucion"] else now
            duracion_min = int((t_fin - t_ini).total_seconds() / 60)
        except Exception:
            pass
        item["tiempo_retencion_min"] = duracion_min
        results.append(item)

    return jsonify(results)


@app.route("/api/retenciones/<int:ret_id>/resolver", methods=["POST"])
@login_required
def resolve_retention_endpoint(ret_id):
    data = request.get_json() or {}
    resolucion = data.get("resolucion")  # 'ACLARAR', 'CORREGIR', 'RECHAZAR'
    motivo = data.get("motivo_rechazo")
    observacion = data.get("observacion")

    user = session["user"]
    res = resolve_retention(ret_id, resolucion, user["username"], user["rol"], motivo, observacion)

    if not res.get("success"):
        return jsonify({"error": res.get("error")}), 400

    # Comandar AgujaLiberar via MQTT al controlador
    if mqtt_client:
        mqtt_client.publish("portus/cmd/solicitud", json.dumps({
            "comando": "AgujaLiberar",
            "parametros": {"plaza": res["plaza_liberada"]}
        }))

    # Regla obligatoria: toda resolucion notifica al transportista propietario
    conn = get_db_connection()
    turno = conn.execute("SELECT * FROM turnos WHERE id = ?", (res["turno_id"],)).fetchone()
    ret = conn.execute("SELECT * FROM retenciones WHERE id = ?", (ret_id,)).fetchone()
    conn.close()
    if turno and ret:
        notifier.send(
            turno["transportista_id"],
            msg_service.notify_retencion_resuelta(
                turno["transportista_id"], turno["placa_vehiculo"], turno["contenedor_id"],
                resolucion,
                nuevo_peso=ret["peso_medido_g"] if resolucion == "CORREGIR" else None,
                motivo=motivo if resolucion == "RECHAZAR" else None
            )
        )
        # Rechazar deja el turno Anulado: ademas corre el aviso de anulacion.
        if resolucion == "RECHAZAR":
            notifier.send(
                turno["transportista_id"],
                msg_service.notify_turno_anulado(
                    turno["transportista_id"], turno["placa_vehiculo"], turno["contenedor_id"],
                    motivo or "Rechazo de la retencion"
                )
            )

    _refresh_parqueo_state()
    dispatch_event_to_sse({"topic": "portus/evt/retencion", "data": {"tipo": "RetencionResuelta", "datos": res}})
    return jsonify(res)


# -------------------------------------------------------------
# API: PATIO Y GRUA
# -------------------------------------------------------------
@app.route('/api/carga')
@login_required
def list_carga():
    conn = get_db_connection()
    manifests = [dict(r) for r in conn.execute('SELECT * FROM manifiestos ORDER BY created_at DESC')]
    turns = [dict(r) for r in conn.execute('SELECT * FROM turnos ORDER BY id DESC')]
    cells = get_yard_inventory()
    ids = {m['contenedor_id'] for m in manifests} | {t['contenedor_id'] for t in turns} | {c['contenedor_id'] for c in cells if c['contenedor_id']}
    result = []
    for cid in sorted(ids):
        m = next((m for m in manifests if m['contenedor_id']==cid), None)
        t = next((t for t in turns if t['contenedor_id']==cid), None)
        c = next((c for c in cells if c['contenedor_id']==cid), None)
        owner = (m or {}).get('naviera_id') or (t or {}).get('naviera_id') or (c or {}).get('naviera_id')
        if session['user']['rol']=='NAVIERA' and owner != session['user']['username']:
            continue
        location = f"P{c['posicion']} N{c['nivel']}" if c else (t['estacion_actual'] if t else 'Sin ingreso observado')
        physical = 'En patio' if c else t['estado_actual'] if t else 'Sin ingreso observado'
        result.append({'contenedor':cid,'naviera':owner or '-', 'manifiesto':m['id'] if m else None,
                       'ubicacion':location,'estado':physical,'estadoPatio':physical,
                       'estadoDoc':m['estado_documental'] if m else 'SIN_DOCUMENTO',
                       'autorizacion':m['estado_documental'] if m else 'SIN_DOCUMENTO',
                       'canal':m['canal_selectivo'] if m else None,
                       'permanencia':c['permanencia_str'] if c else '-',
                       'excesiva':c['permanencia_excesiva'] if c else False,
                       'ingreso':c['ingreso_at'] if c else None, 'remociones':c['remociones'] if c else 0,
                       'bloqueada':c['bloqueada'] if c else 0})
    conn.close()
    return jsonify(result)


@app.route("/api/patio", methods=["GET"])
@login_required
def get_patio():
    inv = get_yard_inventory()
    for cell in inv:
        observed = terminal_state.get('patio_fisico', {}).get(str(cell['posicion']))
        cell['confirmado'] = observed is not None
        cell['ocupada_fisica'] = int(observed['niveles']) > cell['nivel'] if observed else None
        cell['estado_fisico'] = observed['estado'] if observed else 'SIN_CONFIRMAR'
        if observed:
            cell['bloqueada'] = int(observed['estado']=='BLOQUEADA')
    if session['user']['rol'] == 'NAVIERA':
        inv = [cell for cell in inv if cell['naviera_id'] == session['user']['username']]
    return jsonify(inv)


@app.route("/api/patio/posicion/<int:pos>/bloquear", methods=["POST"])
@login_required
@require_permission("emitir_comandos_remotos")
def bloquear_posicion(pos):
    set_position_blocked(pos, True)
    if mqtt_client:
        mqtt_client.publish("portus/cmd/solicitud", json.dumps({
            "comando": "PosicionBloquear", "parametros": {"posicion": pos}
        }))
    return jsonify({"success": True, "message": f"Posicion {pos} bloqueada"})


@app.route("/api/patio/posicion/<int:pos>/liberar", methods=["POST"])
@login_required
@require_permission("emitir_comandos_remotos")
def liberar_posicion(pos):
    set_position_blocked(pos, False)
    if mqtt_client:
        mqtt_client.publish("portus/cmd/solicitud", json.dumps({
            "comando": "PosicionLiberar", "parametros": {"posicion": pos}
        }))
    return jsonify({"success": True, "message": f"Posicion {pos} liberada"})


@app.route("/api/grua/historial", methods=["GET"])
@login_required
def get_grua_history_api():
    limit = int(request.args.get("limit", 50))
    hist = get_crane_history(limit)
    return jsonify(hist)


# -------------------------------------------------------------
# API: ALARMAS (CATALOGO AL01-AL14)
# -------------------------------------------------------------
@app.route("/api/alarmas", methods=["GET"])
@login_required
def list_alarmas():
    sev = request.args.get("severidad")
    alarms = get_alarms(sev)
    return jsonify(alarms)


@app.route("/api/alarmas/<int:alarm_id>/reconocer", methods=["POST"])
@login_required
@require_permission("reconocer_alarmas")
def ack_alarm(alarm_id):
    data = request.get_json() or {}
    comentario = data.get("comentario")
    user = session["user"]["username"]
    ok = acknowledge_alarm(alarm_id, user, comentario)
    if not ok:
        return jsonify({"error": "La alarma no existe o ya fue reconocida"}), 400
    return jsonify({"success": True, "message": "Alarma reconocida"})


@app.route("/api/alarmas/reconocer-todas", methods=["POST"])
@login_required
@require_permission("reconocer_alarmas")
def ack_all_alarms():
    user = session["user"]["username"]
    count = acknowledge_all_low_medium(user)
    return jsonify({"success": True, "reconocidas": count, "message": f"{count} alarmas de severidad baja y media reconocidas"})


@app.route("/api/turnos", methods=["POST"])
@login_required
@require_permission("emitir_comandos_remotos")
def crear_turno_desde_plataforma():
    """
    Registra la presentacion de un vehiculo en la garita. Replica la validacion
    que realiza el servidor al recibir la identificacion del controlador:
    manifiesto con levante otorgado (efecto fisico obligatorio sobre la
    talanquera), vehiculo registrado y cumplimiento de la ventana de la cita.
    Un ingreso rechazado no crea turno (regla de la maquina de estados).
    """
    data = request.get_json() or {}
    placa = (data.get("placa_vehiculo") or "").strip().upper()
    manifiesto_id = (data.get("manifiesto_id") or "").strip().upper()

    if not placa or not manifiesto_id:
        return jsonify({"error": "Debe indicar la placa del vehiculo y el manifiesto"}), 400

    conn = get_db_connection()

    camion = conn.execute(
        "SELECT * FROM catalogo_camiones WHERE placa = ? OR rfid_uid = ?", (placa, placa)
    ).fetchone()
    if not camion:
        conn.close()
        return jsonify({"error": f"Vehiculo '{placa}' no registrado en el catalogo. Ingreso rechazado."}), 400
    placa = camion["placa"]

    manif = conn.execute("SELECT * FROM manifiestos WHERE id = ?", (manifiesto_id,)).fetchone()
    if not manif:
        conn.close()
        return jsonify({"error": f"Manifiesto '{manifiesto_id}' no encontrado. Ingreso rechazado."}), 400

    if manif["estado_documental"] == "LEVANTE_RETENIDO":
        conn.close()
        return jsonify({
            "error": "La talanquera no se abre: el manifiesto tiene el levante RETENIDO por la Autoridad Aduanera.",
            "causa_rechazo": "LEVANTE_RETENIDO"
        }), 400

    if manif["estado_documental"] != "LEVANTE_OTORGADO":
        conn.close()
        return jsonify({
            "error": f"La talanquera no se abre: el manifiesto no tiene levante otorgado (estado: {manif['estado_documental']}).",
            "causa_rechazo": "SIN_LEVANTE"
        }), 400

    if camion["transportista_id"] != manif["transportista_id"]:
        conn.close()
        return jsonify({"error": "El vehiculo no pertenece al transportista asignado al manifiesto. Ingreso rechazado."}), 400

    turno_activo = conn.execute("""
    SELECT id FROM turnos
    WHERE placa_vehiculo = ? AND estado_actual NOT IN ('Cerrado', 'Anulado')
    """, (placa,)).fetchone()
    if turno_activo:
        conn.close()
        return jsonify({"error": f"El vehiculo {placa} ya tiene un turno activo dentro de la terminal."}), 400

    # Control de ventana: cita vigente del contenedor para hoy
    ahora = datetime.now()
    fecha_hoy = ahora.strftime("%Y-%m-%d")
    cita = conn.execute("""
    SELECT * FROM citas
    WHERE contenedor_id = ? AND fecha = ? AND estado = 'PROGRAMADA'
    ORDER BY id DESC LIMIT 1
    """, (manif["contenedor_id"], fecha_hoy)).fetchone()

    fuera_de_ventana = True
    cita_id = None
    if cita:
        try:
            h_ini = datetime.strptime(f"{cita['fecha']} {cita['hora_inicio']}", "%Y-%m-%d %H:%M")
            h_fin = datetime.strptime(f"{cita['fecha']} {cita['hora_fin']}", "%Y-%m-%d %H:%M")
            limite = h_fin.timestamp() + 5 * 60  # 5 minutos de tolerancia
            fuera_de_ventana = not (h_ini.timestamp() <= ahora.timestamp() <= limite)
            cita_id = cita["id"]
        except Exception:
            fuera_de_ventana = True

    riesgo_retencion = fuera_de_ventana or manif["canal_selectivo"] == "ROJO"

    # E11: parqueo lleno y vehiculo con riesgo de retencion -> garita rechaza el ingreso
    if riesgo_retencion:
        plazas = get_parking_occupancy()
        if all(p is not None for p in plazas.values()):
            conn.close()
            raise_alarm("AL11", origen="servidor", datos={"descripcion": "Parqueo de retencion lleno: ingreso rechazado en garita"})
            return jsonify({
                "error": "Ingreso rechazado: parqueo de retencion lleno (3/3 plazas ocupadas) y el vehiculo presenta riesgo de retencion.",
                "causa_rechazo": "PARQUEO_LLENO"
            }), 400

    turno_id = create_turn(
        placa=placa,
        transportista_id=manif["transportista_id"],
        contenedor_id=manif["contenedor_id"],
        tipo_operacion=manif["tipo_operacion"],
        manifiesto_id=manif["id"],
        cita_id=cita_id,
        peso_declarado_g=manif["peso_declarado_g"]
    )

    respuesta = {
        "success": True,
        "turno_id": turno_id,
        "message": f"Turno creado. Talanquera abierta para el vehiculo {placa}."
    }

    if cita and not fuera_de_ventana:
        conn.execute(
            "UPDATE citas SET estado = 'CUMPLIDA', cumplida_en_ventana = 1 WHERE id = ?",
            (cita["id"],)
        )
        conn.commit()
    conn.close()

    # RT04: llegada fuera de la ventana asignada -> retencion y desvio al parqueo
    if fuera_de_ventana:
        res = assign_retention(
            turno_id=turno_id,
            causa="RT04",
            estacion="GARITA",
            observacion="Llegada fuera de la ventana asignada a la cita"
        )
        if res:
            if mqtt_client:
                mqtt_client.publish("portus/cmd/solicitud", json.dumps({
                    "comando": "AgujaParqueo", "parametros": {"plaza": res["plaza"]}
                }))
            notifier.send(
                manif["transportista_id"],
                msg_service.notify_vehiculo_retenido(
                    manif["transportista_id"], placa, manif["contenedor_id"], "RT04"
                )
            )
            _refresh_parqueo_state()
            dispatch_event_to_sse({"topic": "portus/evt/retencion", "data": {"tipo": "RetencionCreada", "datos": res}})
            respuesta["retencion"] = res
            respuesta["message"] = f"Vehiculo {placa} ingreso FUERA DE VENTANA. Retencion RT04 asignada a plaza {res['plaza']}."
        else:
            raise_alarm("AL11", origen="servidor", datos={"descripcion": "Parqueo de retencion lleno"})
            respuesta["advertencia"] = "Parqueo lleno: el vehiculo permanece en garita a la espera de plaza."

    terminal_state["garita"]["estado"] = "Autorizada"
    terminal_state["garita"]["vehiculo"] = placa
    dispatch_event_to_sse({"topic": "portus/evt/garita", "data": {"tipo": "TurnoCreado", "datos": {"placa": placa, "turno_id": turno_id}}})

    return jsonify(respuesta)


# -------------------------------------------------------------
# API: CITAS
# -------------------------------------------------------------
@app.route("/api/citas", methods=["GET"])
@login_required
def list_citas():
    conn = get_db_connection()
    fecha = request.args.get("fecha", datetime.now().strftime("%Y-%m-%d"))
    citas = conn.execute("SELECT * FROM citas WHERE fecha = ? ORDER BY hora_inicio ASC", (fecha,)).fetchall()
    conn.close()
    return jsonify([dict(c) for c in citas])


def _datos_cita(cita_id):
    conn = get_db_connection()
    cita = conn.execute("SELECT * FROM citas WHERE id = ?", (cita_id,)).fetchone()
    conn.close()
    return dict(cita) if cita else None


def _franja_ocupacion(fecha: str, hora_inicio: str, excluir_cita_id=None) -> int:
    conn = get_db_connection()
    if excluir_cita_id:
        row = conn.execute("""
        SELECT COUNT(*) as c FROM citas
        WHERE fecha = ? AND hora_inicio = ? AND estado = 'PROGRAMADA' AND id != ?
        """, (fecha, hora_inicio, excluir_cita_id)).fetchone()
    else:
        row = conn.execute("""
        SELECT COUNT(*) as c FROM citas
        WHERE fecha = ? AND hora_inicio = ? AND estado = 'PROGRAMADA'
        """, (fecha, hora_inicio)).fetchone()
    conn.close()
    return row["c"]


def _franja_bloqueada(fecha: str, hora_inicio: str) -> bool:
    conn = get_db_connection()
    row = conn.execute(
        "SELECT id FROM franjas_bloqueadas WHERE fecha = ? AND hora_inicio = ?",
        (fecha, hora_inicio)
    ).fetchone()
    conn.close()
    return row is not None


def _hora_fin_de(hora_inicio: str) -> str:
    h_ini = datetime.strptime(hora_inicio, "%H:%M")
    return (h_ini + timedelta(minutes=15)).strftime("%H:%M")


@app.route("/api/citas/franjas-bloqueadas", methods=["GET"])
@login_required
@require_permission("ver_agenda_completa_citas")
def list_franjas_bloqueadas():
    conn = get_db_connection()
    fecha = request.args.get("fecha", datetime.now().strftime("%Y-%m-%d"))
    rows = conn.execute(
        "SELECT * FROM franjas_bloqueadas WHERE fecha = ? ORDER BY hora_inicio ASC",
        (fecha,)
    ).fetchall()
    conn.close()
    return jsonify([dict(r) for r in rows])


@app.route("/api/citas/<int:cita_id>/cancelar", methods=["POST"])
@login_required
@require_permission("ver_agenda_completa_citas")
def cancelar_cita(cita_id):
    data = request.get_json(silent=True) or {}
    motivo = data.get("motivo", "Cancelada por el operador de terminal")

    cita = _datos_cita(cita_id)
    if not cita:
        return jsonify({"error": "Cita no encontrada"}), 404
    if cita["estado"] != "PROGRAMADA":
        return jsonify({"error": "Solo puede cancelarse una cita en estado PROGRAMADA"}), 400

    conn = get_db_connection()
    conn.execute("UPDATE citas SET estado = 'CANCELADA' WHERE id = ?", (cita_id,))
    conn.commit()
    conn.close()

    notifier.send(
        cita["transportista_id"],
        msg_service.notify_cita_cancelada_reprogramada(
            cita["transportista_id"], cita["contenedor_id"], "cancelada"
        )
    )
    logging.info("Cita %s cancelada (motivo: %s)", cita_id, motivo)

    dispatch_event_to_sse({"topic": "portus/evt/citas", "data": {"tipo": "CitaCancelada", "datos": {"cita_id": cita_id}}})
    return jsonify({"success": True, "message": f"Cita del contenedor {cita['contenedor_id']} cancelada y transportista notificado"})


@app.route("/api/citas/<int:cita_id>/reprogramar", methods=["POST"])
@login_required
@require_permission("ver_agenda_completa_citas")
def reprogramar_cita(cita_id):
    data = request.get_json() or {}
    fecha_nueva = (data.get("fecha") or "").strip()
    hora_nueva = (data.get("hora_inicio") or "").strip()

    if not fecha_nueva or not hora_nueva:
        return jsonify({"error": "Debe indicar la fecha y la hora de inicio de la franja nueva"}), 400

    try:
        datetime.strptime(fecha_nueva, "%Y-%m-%d")
        hora_fin_nueva = _hora_fin_de(hora_nueva)
    except (ValueError, TypeError):
        return jsonify({"error": "Formato invalido. Fecha AAAA-MM-DD y hora HH:MM"}), 400

    cita = _datos_cita(cita_id)
    if not cita:
        return jsonify({"error": "Cita no encontrada"}), 404
    if cita["estado"] != "PROGRAMADA":
        return jsonify({"error": "Solo puede reprogramarse una cita en estado PROGRAMADA"}), 400

    if _franja_bloqueada(fecha_nueva, hora_nueva):
        return jsonify({"error": f"La franja {fecha_nueva} {hora_nueva} esta bloqueada y no admite nuevas citas"}), 400

    if _franja_ocupacion(fecha_nueva, hora_nueva, excluir_cita_id=cita_id) >= 2:
        return jsonify({"error": f"La franja {fecha_nueva} {hora_nueva} esta llena (2/2 citas). Seleccione otra franja."}), 400

    conn = get_db_connection()
    conn.execute("""
    UPDATE citas SET fecha = ?, hora_inicio = ?, hora_fin = ?, cumplida_en_ventana = 0
    WHERE id = ?
    """, (fecha_nueva, hora_nueva, hora_fin_nueva, cita_id))
    conn.commit()
    conn.close()

    notifier.send(
        cita["transportista_id"],
        msg_service.notify_cita_cancelada_reprogramada(
            cita["transportista_id"], cita["contenedor_id"], "reprogramada",
            nueva_ventana=f"{fecha_nueva} de {hora_nueva} a {hora_fin_nueva}"
        )
    )

    dispatch_event_to_sse({"topic": "portus/evt/citas", "data": {"tipo": "CitaReprogramada", "datos": {"cita_id": cita_id}}})
    return jsonify({"success": True, "message": f"Cita reprogramada a {fecha_nueva} {hora_nueva}-{hora_fin_nueva} y notificada al transportista"})


@app.route("/api/citas/bloquear-franja", methods=["POST"])
@login_required
@require_permission("ver_agenda_completa_citas")
def bloquear_franja():
    data = request.get_json() or {}
    fecha = (data.get("fecha") or "").strip()
    hora_inicio = (data.get("hora_inicio") or "").strip()

    if not fecha or not hora_inicio:
        return jsonify({"error": "Debe indicar fecha (AAAA-MM-DD) y hora de inicio (HH:MM) de la franja"}), 400

    try:
        datetime.strptime(fecha, "%Y-%m-%d")
        hora_fin = _hora_fin_de(hora_inicio)
    except (ValueError, TypeError):
        return jsonify({"error": "Formato invalido. Fecha AAAA-MM-DD y hora HH:MM"}), 400

    if _franja_bloqueada(fecha, hora_inicio):
        return jsonify({"error": "La franja ya se encuentra bloqueada"}), 400

    now = datetime.now(timezone.utc).isoformat()
    conn = get_db_connection()
    conn.execute("""
    INSERT INTO franjas_bloqueadas (fecha, hora_inicio, hora_fin, creado_por, created_at)
    VALUES (?, ?, ?, ?, ?)
    """, (fecha, hora_inicio, hora_fin, session["user"]["username"], now))
    conn.commit()
    conn.close()

    dispatch_event_to_sse({"topic": "portus/evt/citas", "data": {"tipo": "FranjaBloqueada", "datos": {"fecha": fecha, "hora_inicio": hora_inicio}}})
    return jsonify({"success": True, "message": f"Franja {fecha} {hora_inicio}-{hora_fin} bloqueada: no admite nuevas citas"})


@app.route("/api/citas/desbloquear-franja", methods=["POST"])
@login_required
@require_permission("ver_agenda_completa_citas")
def desbloquear_franja():
    data = request.get_json() or {}
    fecha = (data.get("fecha") or "").strip()
    hora_inicio = (data.get("hora_inicio") or "").strip()

    conn = get_db_connection()
    cur = conn.execute(
        "DELETE FROM franjas_bloqueadas WHERE fecha = ? AND hora_inicio = ?",
        (fecha, hora_inicio)
    )
    conn.commit()
    conn.close()

    if cur.rowcount == 0:
        return jsonify({"error": "La franja no estaba bloqueada"}), 400

    dispatch_event_to_sse({"topic": "portus/evt/citas", "data": {"tipo": "FranjaDesbloqueada", "datos": {"fecha": fecha, "hora_inicio": hora_inicio}}})
    return jsonify({"success": True, "message": f"Franja {fecha} {hora_inicio} desbloqueada"})


# -------------------------------------------------------------
# API: REPORTES Y METRICAS DE CORRIDA
# -------------------------------------------------------------
@app.route("/api/reportes/calcular", methods=["GET"])
@login_required
@require_permission("generar_reporte_corrida")
def report_metrics():
    ini = request.args.get("inicio")
    fin = request.args.get("fin")
    metrics = calculate_metrics(ini, fin)
    return jsonify(metrics)


@app.route("/api/reportes/exportar-csv", methods=["POST"])
@login_required
@require_permission("generar_reporte_corrida")
def export_metrics_csv():
    data = request.get_json() or {}
    etiqueta = data.get("etiqueta", "Corrida de evaluacion")
    ini = data.get("inicio")
    fin = data.get("fin")

    metrics = calculate_metrics(ini, fin)
    csv_str = export_report_csv(etiqueta, metrics)

    return Response(
        csv_str,
        mimetype="text/csv",
        headers={"Content-Disposition": f"attachment; filename=reporte_{etiqueta.replace(' ', '_')}.csv"}
    )


# -------------------------------------------------------------
# API: VINCULACION DE TRANSPORTISTA
# -------------------------------------------------------------
@app.route("/api/transportista/generar-codigo", methods=["POST"])
@login_required
@require_permission("generar_codigo_vinculacion")
def gen_binding_code():
    data = request.get_json() or {}
    trans_id = data.get("transportista_id")
    if not trans_id:
        return jsonify({"error": "Debe especificar el transportista"}), 400

    codigo = generate_binding_code(trans_id, creado_por=session["user"]["username"])
    return jsonify({"success": True, "codigo": codigo, "expira_en_minutos": 60})


@app.route("/api/mensajeria/simulador", methods=["POST"])
def simular_comando_transportista():
    """
    Endpoint para probar interactivamente los 7 comandos del transportista
    desde un cliente web, consola o emulador de mensajeria.
    """
    data = request.get_json() or {}
    chat_id = data.get("chat_id", "sim_phone_01")
    texto = data.get("texto", "")

    respuesta = msg_service.process_message(chat_id, texto)
    return jsonify({"chat_id": chat_id, "respuesta": respuesta})


# -------------------------------------------------------------
# SERVICIO DE LA SPA REACT (modo produccion: frontend/dist)
# -------------------------------------------------------------
@app.route("/api/fase3/estado")
@login_required
@require_permission("ver_sinoptico")
def fase3_estado():
    return jsonify(fase3_runtime.snapshot())


@app.route("/api/fase3/parametros", methods=["GET", "PUT"])
@login_required
@require_permission("gestionar_fase3")
def fase3_parametros():
    if request.method == "GET":
        return jsonify(fase3.params())
    try:
        values = fase3.set_params(request.get_json() or {})
    except ValueError as exc:
        return jsonify({"error": str(exc)}), 400
    fase3.audit(session["user"]["username"], "parametros_fase3", request.get_json() or {})
    if mqtt_client:
        mqtt_client.publish("portus/estacion/config", json.dumps({k: values[k] for k in
            ("SegundosLecturaEstacion", "SegundosLatidoEstacion")}), qos=1, retain=True)
        mqtt_client.publish("portus/vision/config", json.dumps({k: values[k] for k in
            ("ConfianzaMinimaOCR", "IntentosOCR", "SegundosConteoCola")}), qos=1, retain=True)
    if "SegundosEsperaVerificacion" in (request.get_json() or {}):
        fase3_runtime.command("GaritaEspera", segundos=int(values["SegundosEsperaVerificacion"]))
    return jsonify(values)


@app.route("/api/fase3/iluminacion", methods=["POST"])
@login_required
@require_permission("gestionar_fase3")
def fase3_iluminacion():
    try:
        with telemetry_lock:
            fase3_runtime.set_mode((request.get_json() or {}).get("modo"), session["user"]["username"])
    except ValueError as exc:
        return jsonify({"error": str(exc)}), 400
    return jsonify(fase3_runtime.snapshot())


@app.route("/api/fase3/garita/modo", methods=["POST"])
@login_required
@require_permission("gestionar_fase3")
def fase3_garita_modo():
    enabled = (request.get_json() or {}).get("activo")
    if not isinstance(enabled, bool):
        return jsonify({"error": "activo debe ser booleano"}), 400
    if enabled and fase3_runtime.camera_online is not True:
        return jsonify({"error": "La camara debe estar operativa para activar dos factores"}), 409
    if not enabled and fase3_runtime.pending_access_id:
        return jsonify({"error": "Resuelva primero el acceso pendiente"}), 409
    if enabled and (mqtt_client is None or terminal_state.get("enlace") != "CONECTADO"):
        return jsonify({"error": "Se requiere enlace real con el controlador"}), 409
    with telemetry_lock:
        fase3_runtime.command("GaritaModo", activo=enabled)
    fase3.audit(session["user"]["username"], "modo_doble_factor", {"activo": enabled})
    return jsonify({"despachado": True, "activo_solicitado": enabled})


@app.route("/api/fase3/placas", methods=["GET", "POST"])
@login_required
def fase3_placas():
    if request.method == "POST" and session["user"]["rol"] != "AUTORIDAD":
        return jsonify({"error": "Solo AUTORIDAD puede restringir placas"}), 403
    if request.method == "GET" and session["user"]["rol"] not in ("AUTORIDAD", "TERMINAL"):
        return jsonify({"error": "Permiso insuficiente"}), 403
    conn = get_db_connection()
    try:
        if request.method == "GET":
            return jsonify([dict(r) for r in conn.execute("SELECT * FROM fase3_placas_restringidas ORDER BY alta_at DESC")])
        data = request.get_json() or {}
        plate = fase3.norm_plate(data.get("placa"))
        reason = str(data.get("motivo") or "").strip()
        if not fase3.PLATE.fullmatch(plate) or len(reason) < 10:
            return jsonify({"error": "Placa C123ABC y motivo de al menos 10 caracteres requeridos"}), 400
        row = conn.execute("SELECT baja_at FROM fase3_placas_restringidas WHERE placa=?", (plate,)).fetchone()
        if row and row["baja_at"] is None:
            return jsonify({"error": "La placa ya esta restringida"}), 409
        conn.execute("INSERT OR REPLACE INTO fase3_placas_restringidas VALUES (?,?,?,?,NULL,NULL,NULL)",
                     (plate, reason, session["user"]["username"], fase3.now()))
        conn.commit()
    finally:
        conn.close()
    fase3.audit(session["user"]["username"], "restringir_placa", {"placa": plate, "motivo": reason})
    return jsonify({"placa": plate}), 201


@app.route("/api/fase3/placas/<placa>/liberar", methods=["POST"])
@login_required
@require_permission("gestionar_placas")
def fase3_liberar_placa(placa):
    reason = str((request.get_json() or {}).get("motivo") or "").strip()
    if len(reason) < 10:
        return jsonify({"error": "Motivo de al menos 10 caracteres requerido"}), 400
    plate = fase3.norm_plate(placa)
    conn = get_db_connection()
    try:
        cur = conn.execute("UPDATE fase3_placas_restringidas SET baja_at=?,usuario_baja=?,motivo_baja=? WHERE placa=? AND baja_at IS NULL",
                           (fase3.now(), session["user"]["username"], reason, plate))
        conn.commit()
        if not cur.rowcount:
            return jsonify({"error": "Placa no restringida"}), 404
    finally:
        conn.close()
    fase3.audit(session["user"]["username"], "liberar_placa", {"placa": plate, "motivo": reason})
    return jsonify({"success": True})


@app.route("/api/fase3/accesos")
@login_required
@require_permission("gestionar_fase3")
def fase3_accesos():
    conn = get_db_connection()
    try:
        return jsonify([dict(r) for r in conn.execute("SELECT * FROM fase3_accesos ORDER BY id DESC LIMIT 200")])
    finally:
        conn.close()


@app.route("/api/fase3/vehiculos", methods=["GET", "POST"])
@login_required
@require_permission("gestionar_fase3")
def fase3_vehiculos():
    conn = get_db_connection()
    try:
        if request.method == "GET":
            return jsonify([dict(r) for r in conn.execute("SELECT * FROM catalogo_camiones ORDER BY placa")])
        data = request.get_json() or {}
        plate = fase3.norm_plate(data.get("placa"))
        uid = str(data.get("rfid_uid") or "").strip().upper()
        owner = str(data.get("transportista_id") or "").strip()
        reason = str(data.get("motivo") or "").strip()
        try:
            tare = int(data.get("tara_g"))
        except (ValueError, TypeError):
            tare = -1
        if not fase3.PLATE.fullmatch(plate) or not re.fullmatch(r"[A-F0-9]{8,20}", uid) or tare < 0 or len(reason) < 10:
            return jsonify({"error": "Placa C123ABC, UID hexadecimal, tara y motivo de 10 caracteres requeridos"}), 400
        if not conn.execute("SELECT 1 FROM usuarios WHERE username=? AND rol='TRANSPORTISTA'", (owner,)).fetchone():
            return jsonify({"error": "Transportista no encontrado"}), 400
        try:
            conn.execute("INSERT INTO catalogo_camiones(placa,transportista_id,tara_g,rfid_uid,activo) VALUES (?,?,?,?,1)",
                         (plate, owner, tare, uid))
            conn.commit()
        except Exception:
            return jsonify({"error": "Placa o RFID ya registrado"}), 409
    finally:
        conn.close()
    fase3.audit(session["user"]["username"], "alta_vehiculo", {"placa": plate, "motivo": reason})
    return jsonify({"placa": plate}), 201


@app.route("/api/fase3/vehiculos/<placa>", methods=["PUT", "DELETE"])
@login_required
@require_permission("gestionar_fase3")
def fase3_modificar_vehiculo(placa):
    data = request.get_json() or {}
    reason = str(data.get("motivo") or "").strip()
    if len(reason) < 10:
        return jsonify({"error": "Motivo de al menos 10 caracteres requerido"}), 400
    old = fase3.norm_plate(placa)
    conn = get_db_connection()
    try:
        if not conn.execute("SELECT 1 FROM catalogo_camiones WHERE placa=?", (old,)).fetchone():
            return jsonify({"error": "Vehiculo no encontrado"}), 404
        if request.method == "DELETE":
            conn.execute("UPDATE catalogo_camiones SET activo=0 WHERE placa=?", (old,))
            action = "desactivar_vehiculo"
            new = old
        else:
            new = fase3.norm_plate(data.get("placa", old))
            uid = str(data.get("rfid_uid") or "").strip().upper()
            if not fase3.PLATE.fullmatch(new) or not re.fullmatch(r"[A-F0-9]{8,20}", uid):
                return jsonify({"error": "Placa o UID invalido"}), 400
            if conn.execute("SELECT 1 FROM turnos WHERE placa_vehiculo=? AND estado_actual NOT IN ('Cerrado','Anulado')", (old,)).fetchone():
                return jsonify({"error": "No modificar placa con turno activo"}), 409
            try:
                conn.execute("UPDATE catalogo_camiones SET placa=?,rfid_uid=? WHERE placa=?", (new, uid, old))
            except Exception:
                return jsonify({"error": "Placa o RFID ya registrado"}), 409
            action = "modificar_vehiculo"
        conn.commit()
    finally:
        conn.close()
    fase3.audit(session["user"]["username"], action, {"anterior": old, "placa": new, "motivo": reason})
    return jsonify({"success": True, "placa": new})


@app.route("/api/fase3/accesos/<int:access_id>/foto")
@login_required
@require_permission("gestionar_fase3")
def fase3_foto(access_id):
    conn = get_db_connection()
    try:
        row = conn.execute("SELECT foto FROM fase3_accesos WHERE id=?", (access_id,)).fetchone()
    finally:
        conn.close()
    if not row or not row["foto"]:
        return jsonify({"error": "Foto no disponible"}), 404
    filename = os.path.basename(row["foto"])
    root = os.path.abspath(os.path.join(os.path.dirname(__file__), "..", "..", "PortusFase3", "fotos"))
    if not os.path.isfile(os.path.join(root, filename)):
        return jsonify({"error": "Foto no encontrada en disco"}), 404
    return send_from_directory(root, filename)


@app.route("/api/fase3/accesos/<int:access_id>/decision", methods=["POST"])
@login_required
@require_permission("gestionar_fase3")
def fase3_decision_acceso(access_id):
    data = request.get_json() or {}
    choice = data.get("decision")
    reason = str(data.get("motivo") or "").strip()
    if choice not in ("CONFIRMAR", "RECHAZAR") or len(reason) < 10:
        return jsonify({"error": "Decision y motivo de al menos 10 caracteres requeridos"}), 400
    with telemetry_lock:
        if not fase3_runtime.gate_enabled or fase3_runtime.pending_access_id != access_id:
            return jsonify({"error": "El acceso ya no es el pendiente en la garita"}), 409
        conn = get_db_connection()
        try:
            row = conn.execute("SELECT * FROM fase3_accesos WHERE id=?", (access_id,)).fetchone()
            if not row or row["resultado"] not in ("VERIFICACION MANUAL", "MODO DEGRADADO"):
                return jsonify({"error": "Verificacion pendiente no encontrada"}), 404
            conn.execute("UPDATE fase3_accesos SET resultado=?,usuario_decision=?,motivo_decision=? WHERE id=?",
                         (choice, session["user"]["username"], reason, access_id))
            conn.commit()
        finally:
            conn.close()
        fase3_runtime.command("GaritaResultado", resultado="AUTORIZAR" if choice == "CONFIRMAR" else "RECHAZAR",
                              placa=row["placa_leida"] or "")
        fase3_runtime.pending_access_id = None
        fase3_runtime.pending_since = None
    fase3.audit(session["user"]["username"], "decision_acceso", {"id": access_id, "decision": choice, "motivo": reason})
    return jsonify({"success": True})


@app.route("/<path:ruta_spa>")
def servir_spa(ruta_spa):
    """
    En produccion la SPA se sirve desde frontend/dist. Las rutas /api/* ya
    fueron registradas con prioridad por Flask, asi que no se interceptan.
    En desarrollo (Vite en 5173 con proxy) esta ruta no se usa.
    """
    if ruta_spa.startswith("api/"):
        return jsonify({"error": "Recurso no encontrado"}), 404

    indice = os.path.join(FRONTEND_DIST, "index.html")
    if not os.path.isfile(indice):
        return _spa_no_construida()

    # Rutas del cliente como /terminal/operacion resuelven el index.html
    # salvo que el archivo exista fisicamente (assets de Vite).
    archivo = os.path.join(FRONTEND_DIST, ruta_spa)
    if os.path.isfile(archivo):
        return send_from_directory(FRONTEND_DIST, ruta_spa)
    return send_from_directory(FRONTEND_DIST, "index.html")


if __name__ == "__main__":
    init_database()
    init_mqtt()
    app.run(host="0.0.0.0", port=5000, debug=False)
