Arreagaaa/ARQUI2_2S2026_G-5/(commit log)

2026-08-29 idea: diagrama de pines
2026-09-23 feat: SPA React para interfaces y limpieza de UI Jinja2
    - Nueva carpeta frontend/ con React 18 + TypeScript + Vite + Tailwind (pnpm)
    - 16 pantallas por rol (TERMINAL, NAVIERA, AGENTE, AUTORIDAD) + login
    - Sinoptico actualizado solo por SSE nativo; fetch wrapper sin axios
    - Backend aditivo: /api/me, /api/transportistas, /api/catalogo/contenedores,
    GET /api/declaraciones, logout JSON y serve de frontend/dist
    - Se eliminan templates Jinja2, static JS/CSS viejos y __pycache__/trackeados
    - .gitignore para Python, Node, *.db y .env (conserva .env.example)
    - status.md: decision vanilla->React, diseno, estado de pantallas y gaps
2026-09-25 feat: latido HB estructurado cada 5s en consola Fase 1
    Emite [SEQ:HB:LatidoEstado::CRC] (CRC16-CCITT) para que el puente Serial-MQTT de Fase 2 supervise el enlace y genere AL01 solo ante corte real, eliminando las alarmas falsas con la maqueta en reposo.
2026-09-25 fix: sinoptico con tramas legacy del INO real
    - referenciada/suspendida/en_falla solo se actualizan si la trama trae el dato (antes cada evento legacy las forzaba a no)
    - pesaje extrae el valor de 'Peso leido: X kg' en tramas legacy (antes quedaba en 0.0 kg)
2026-10-23 feat: add Raspberry Pi environmental station script, requirements, and Phase 3 documentation
2026-10-24 feat: implement automatic environmental station startup and monitoring on Raspberry Pi in run_fase2.py
2026-10-24 Handle ADS1115 near-zero voltage noise
2026-10-24 feat: add Raspberry Pi vision script and configuration for OCR and YOLO counting
